Czolsonn/Oscyloskop/README.md

# Oscyloskop
Projekt amatorskiego oscyloskopu z wyświetlaczem LCD
