Czolsonn/Oscyloskop/Symulacje/_archiwum_stary_uklad/plot's/ADC_Input/ADC_Input_100_47.png

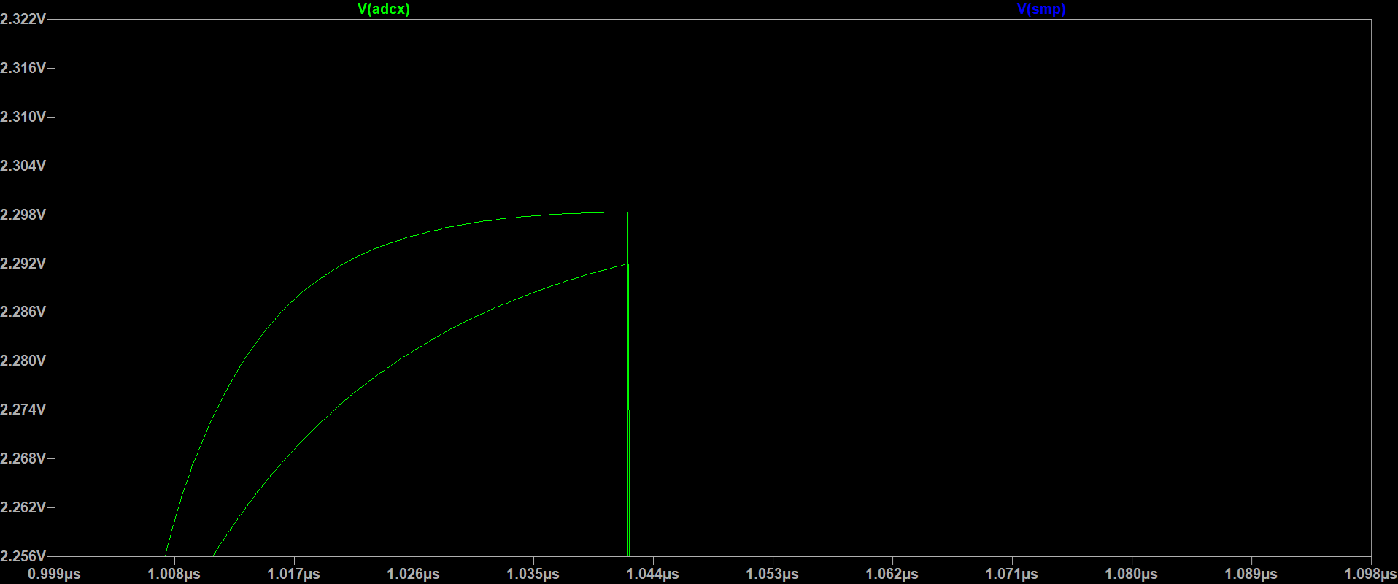
Symulacje/_archiwum_stary_uklad/plot's/ADC_Input/ADC_Input_100_47.png
