Czolsonn/Oscyloskop/Symulacje/_archiwum_stary_uklad/plot's/Bandwidth/Bandwidth.png

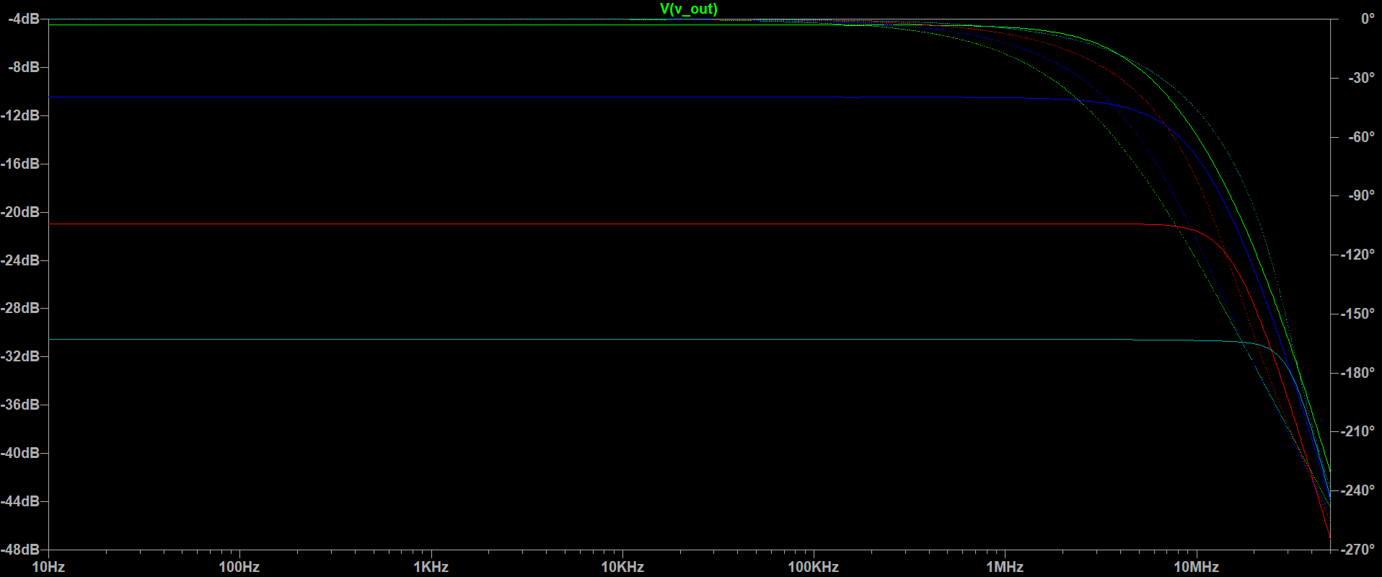
Symulacje/_archiwum_stary_uklad/plot's/Bandwidth/Bandwidth.png
