Czolsonn/Oscyloskop/Symulacje/_archiwum_stary_uklad/plot's/Bandwidth_AC/AC_bandwidth_all_G.png

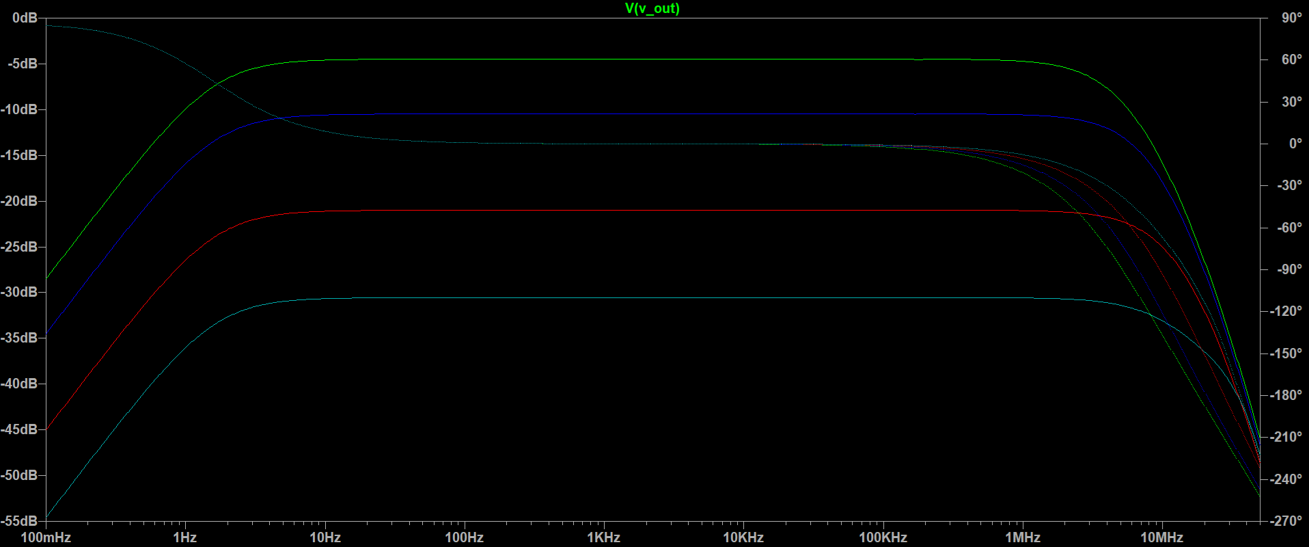
Symulacje/_archiwum_stary_uklad/plot's/Bandwidth_AC/AC_bandwidth_all_G.png
