Czolsonn/Oscyloskop/Symulacje/_archiwum_stary_uklad/plot's/Compensation_C_trim/Compensation_C_trim_closer.png

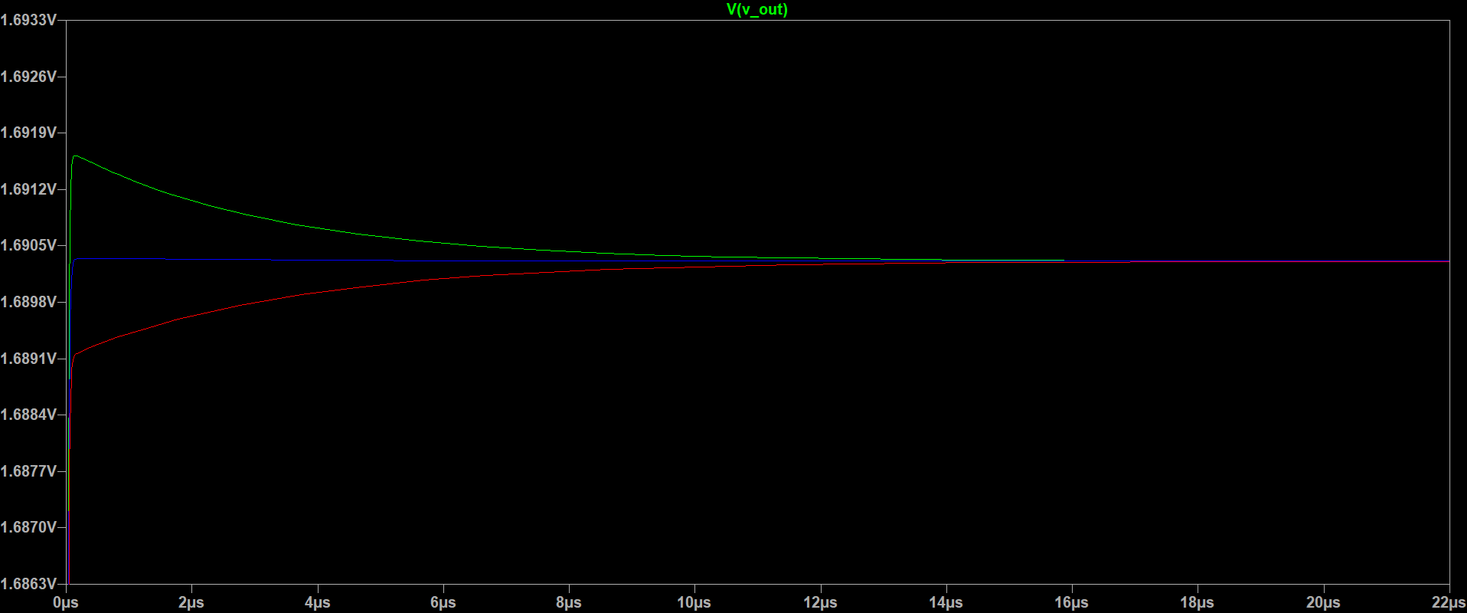
Symulacje/_archiwum_stary_uklad/plot's/Compensation_C_trim/Compensation_C_trim_closer.png
