Czolsonn/Oscyloskop/Symulacje/_archiwum_stary_uklad/plot's/Final/Final_1_signals.png

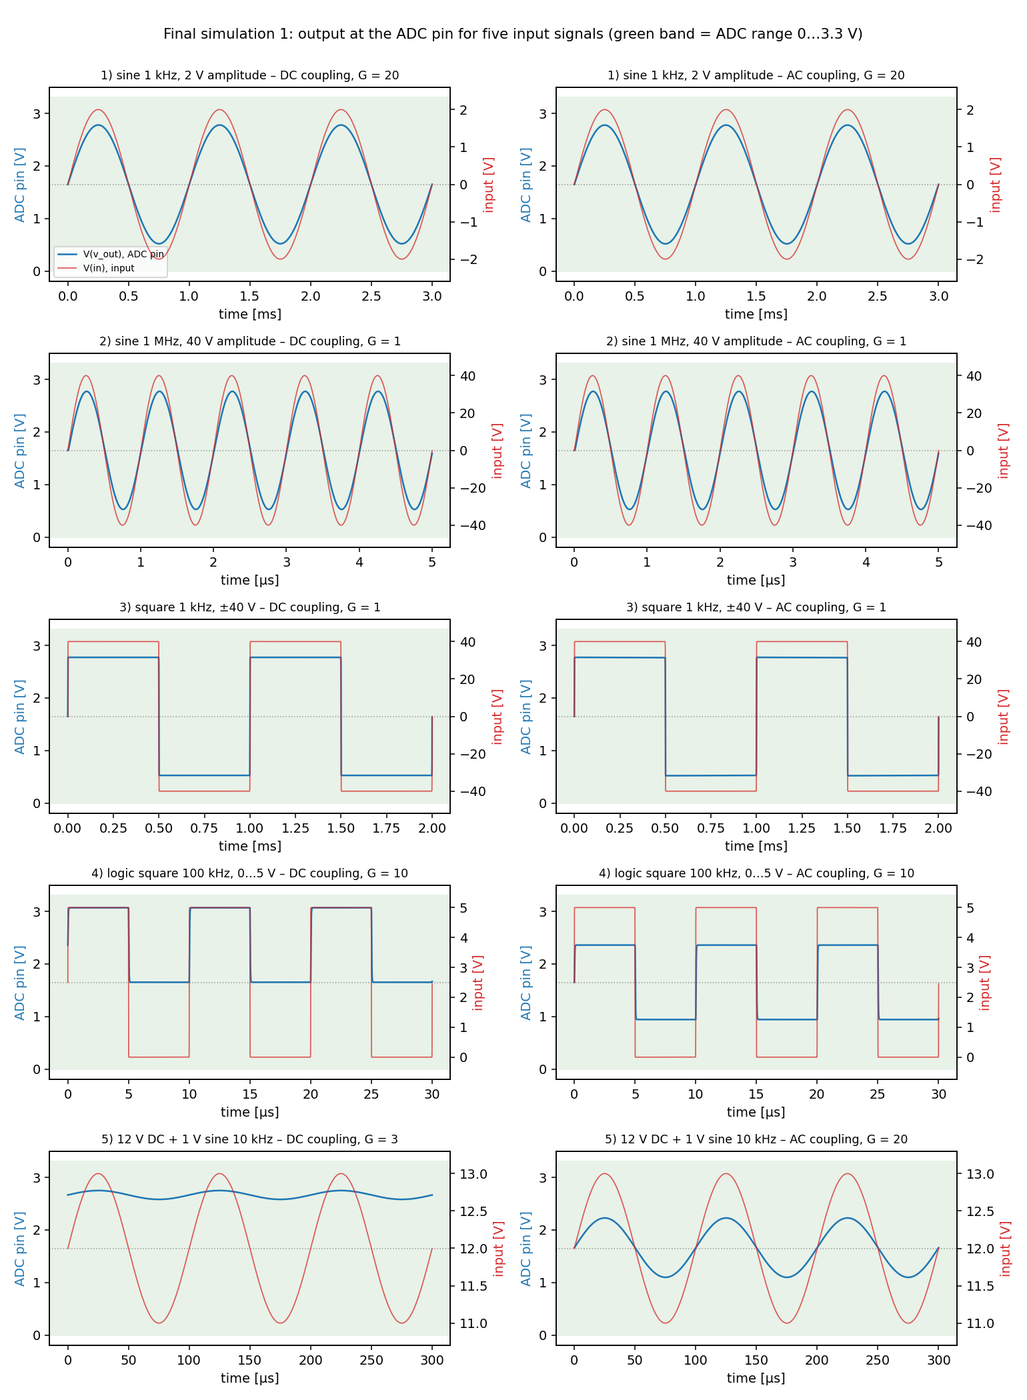
Symulacje/_archiwum_stary_uklad/plot's/Final/Final_1_signals.png
