Czolsonn/Oscyloskop/Symulacje/_archiwum_stary_uklad/plot's/Final/Final_1_square_edge.png

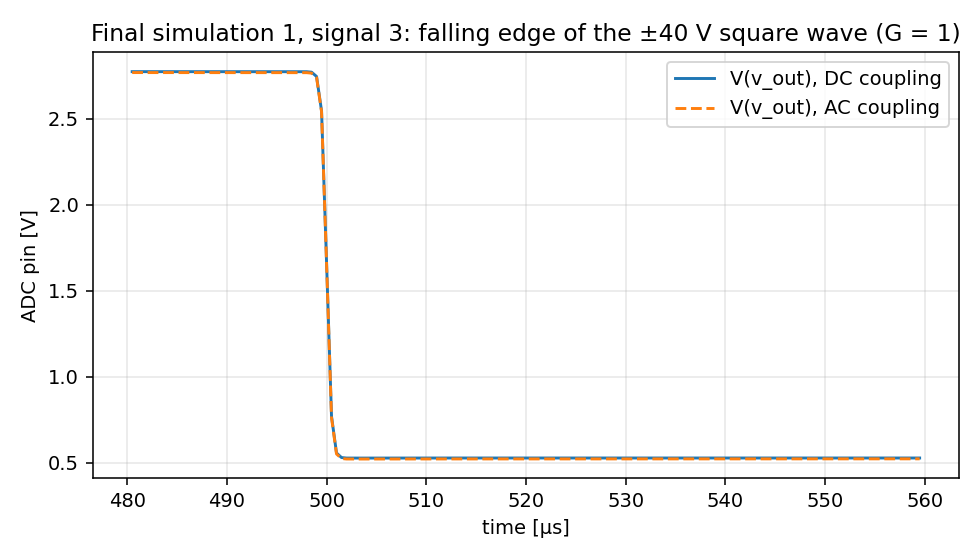
Symulacje/_archiwum_stary_uklad/plot's/Final/Final_1_square_edge.png
