Czolsonn/Oscyloskop/Symulacje/_archiwum_stary_uklad/plot's/Final/Final_2_AC_response.png

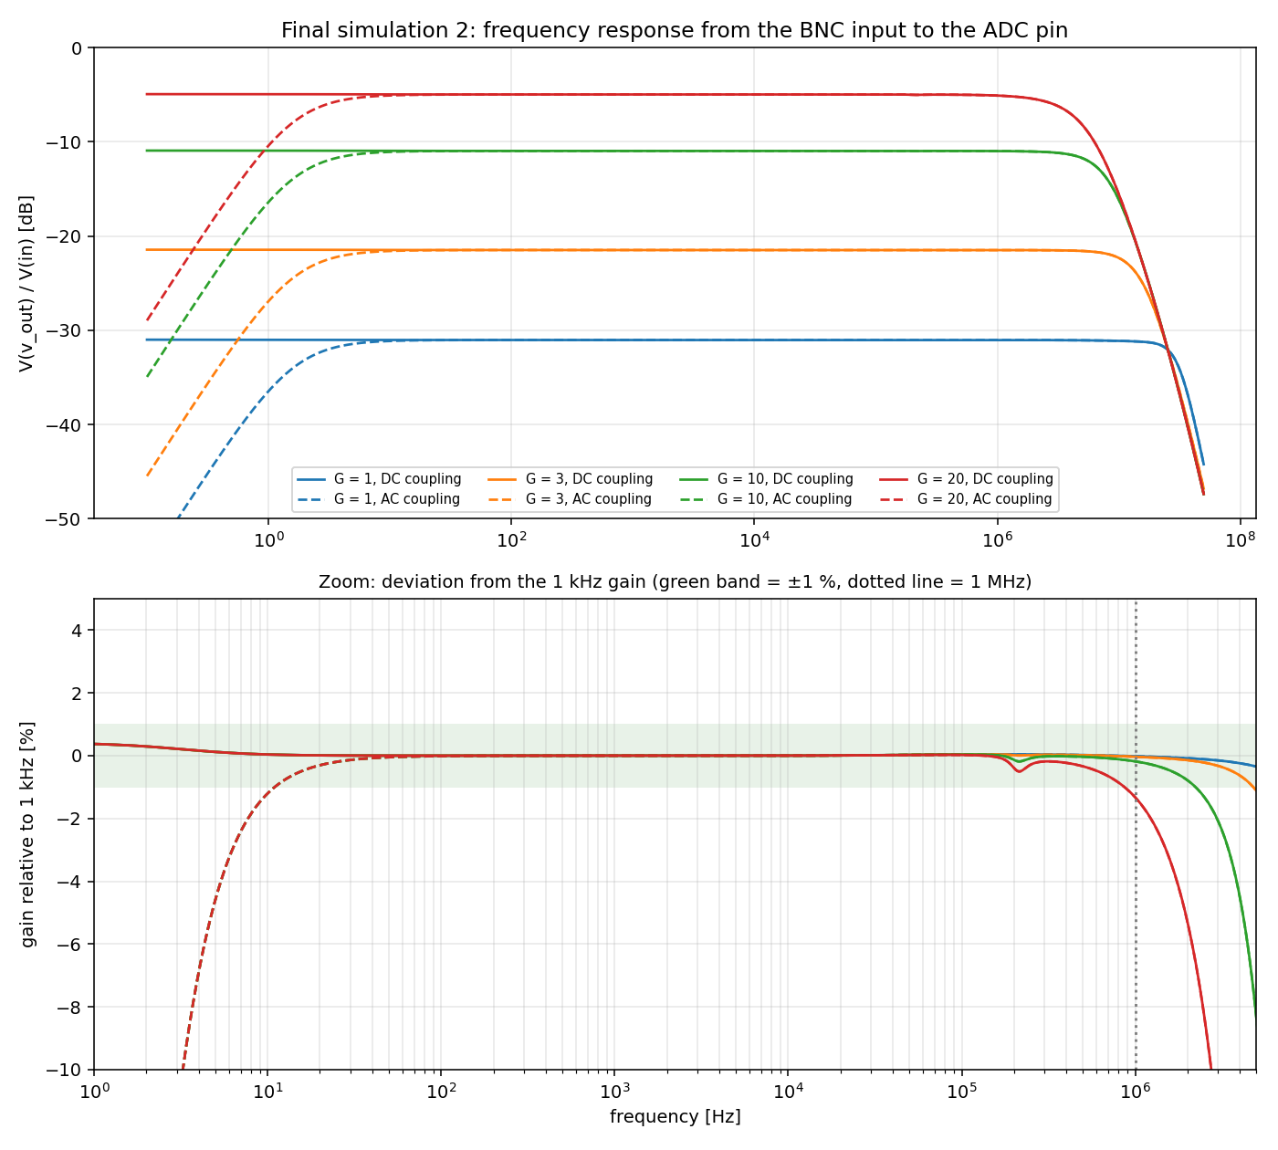
Symulacje/_archiwum_stary_uklad/plot's/Final/Final_2_AC_response.png
