Czolsonn/Oscyloskop/Symulacje/_archiwum_stary_uklad/plot's/Final/Final_3_offset_trim.png

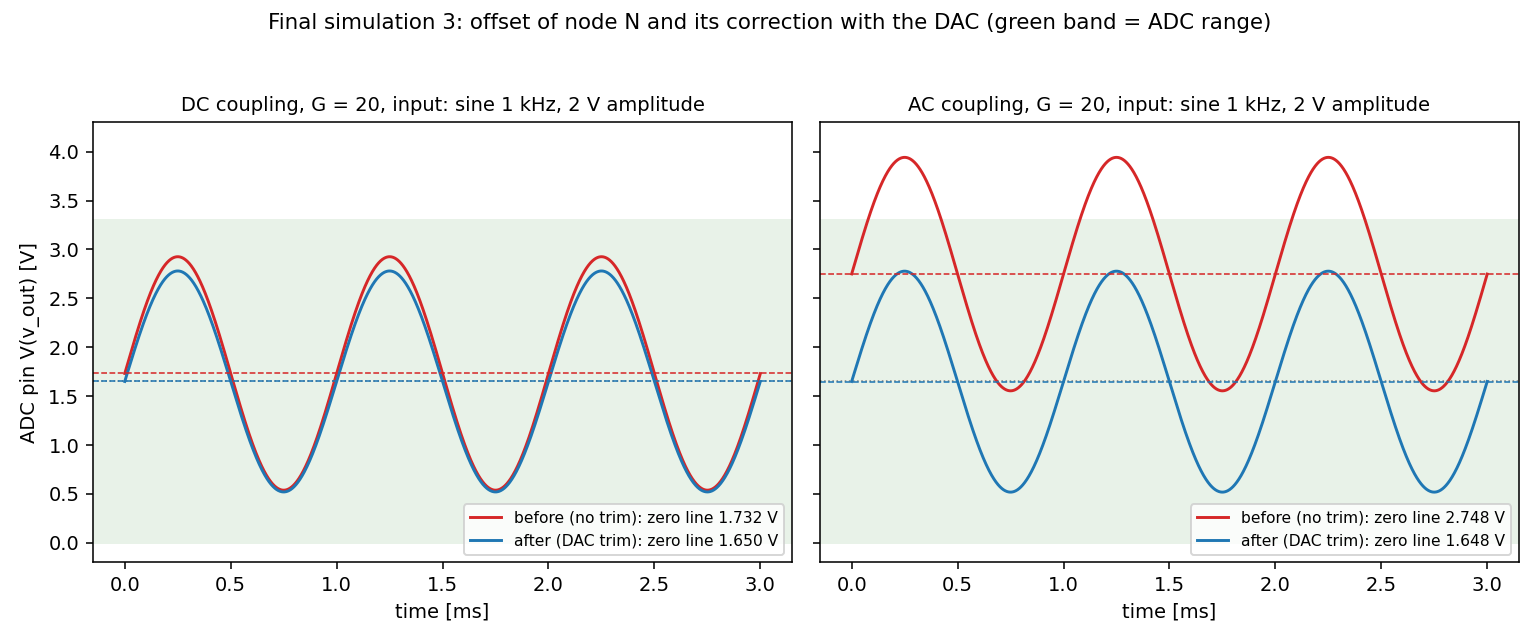
Symulacje/_archiwum_stary_uklad/plot's/Final/Final_3_offset_trim.png
