Czolsonn/Oscyloskop/Symulacje/_archiwum_stary_uklad/plot's/Monte_Carlo/MC_dc_bias.png

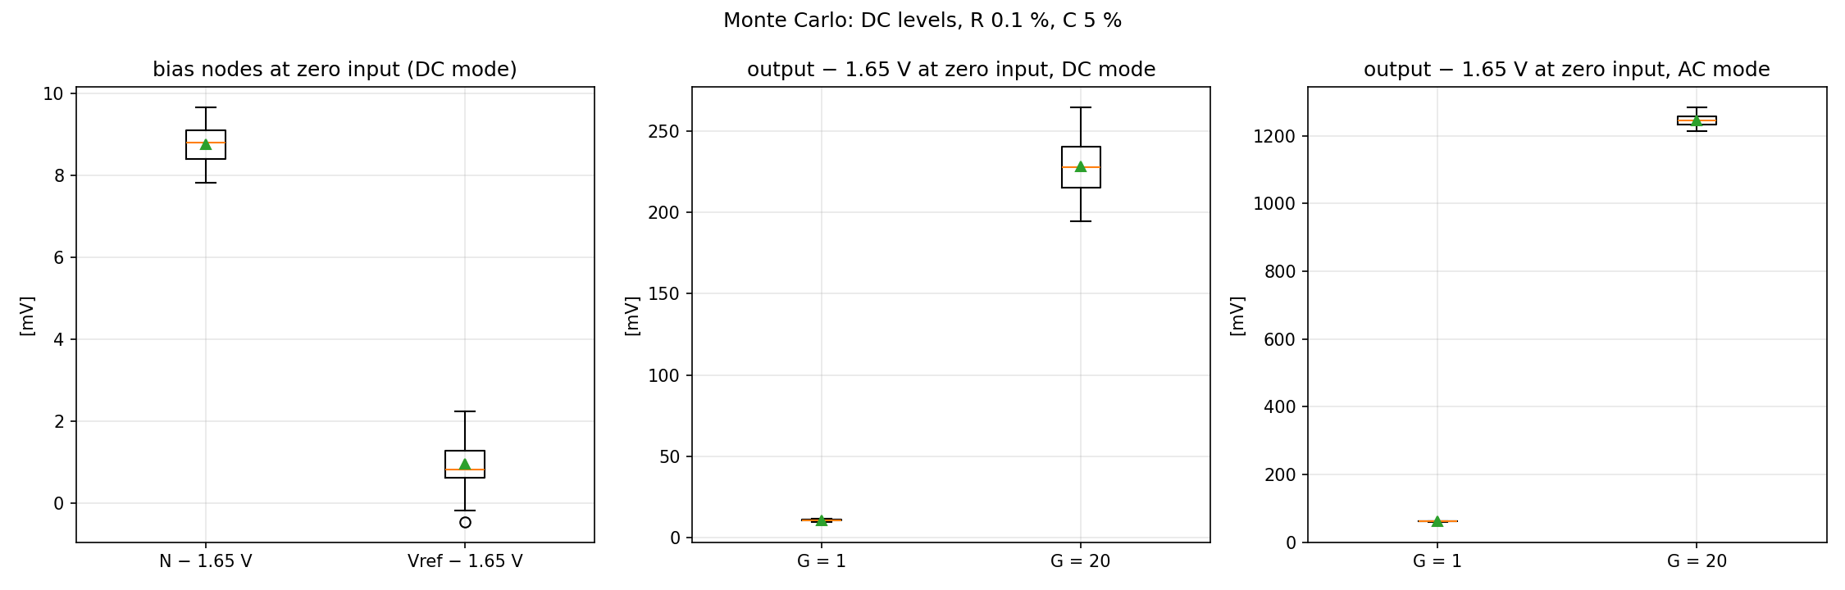
Symulacje/_archiwum_stary_uklad/plot's/Monte_Carlo/MC_dc_bias.png
