Czolsonn/Oscyloskop/Symulacje/_archiwum_stary_uklad/plot's/Power_filtration_LSB_effect/LSB_R_dump_C_bias.png

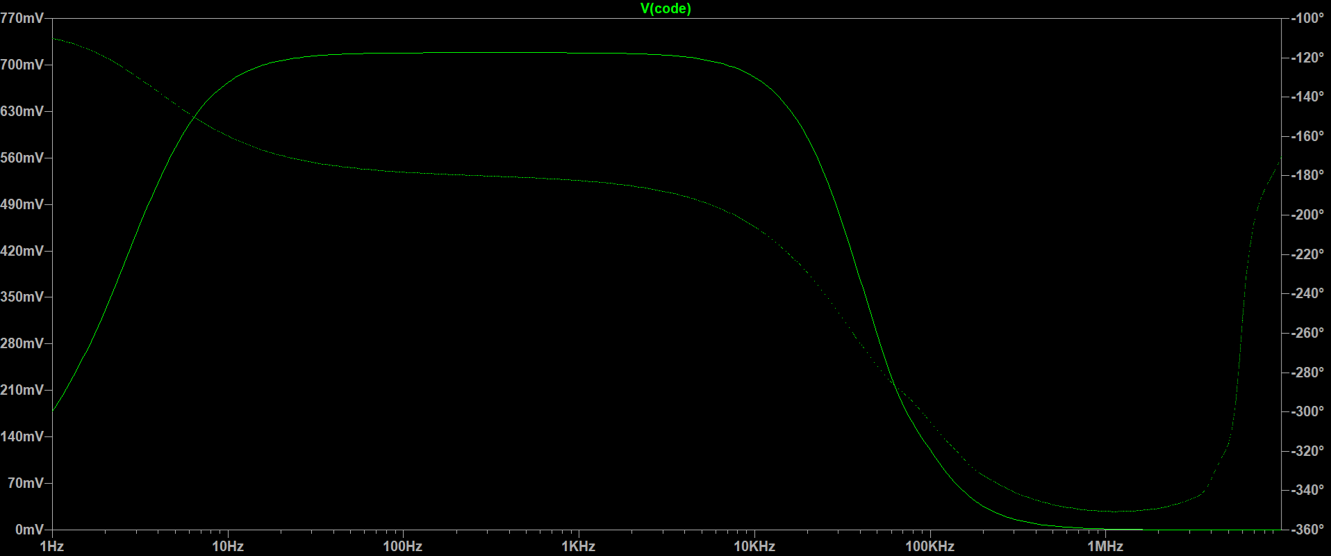
Symulacje/_archiwum_stary_uklad/plot's/Power_filtration_LSB_effect/LSB_R_dump_C_bias.png
