Czolsonn/Oscyloskop/Symulacje/plot's/AFE_v2/LTspice_figures/Fig01_AC_response.png

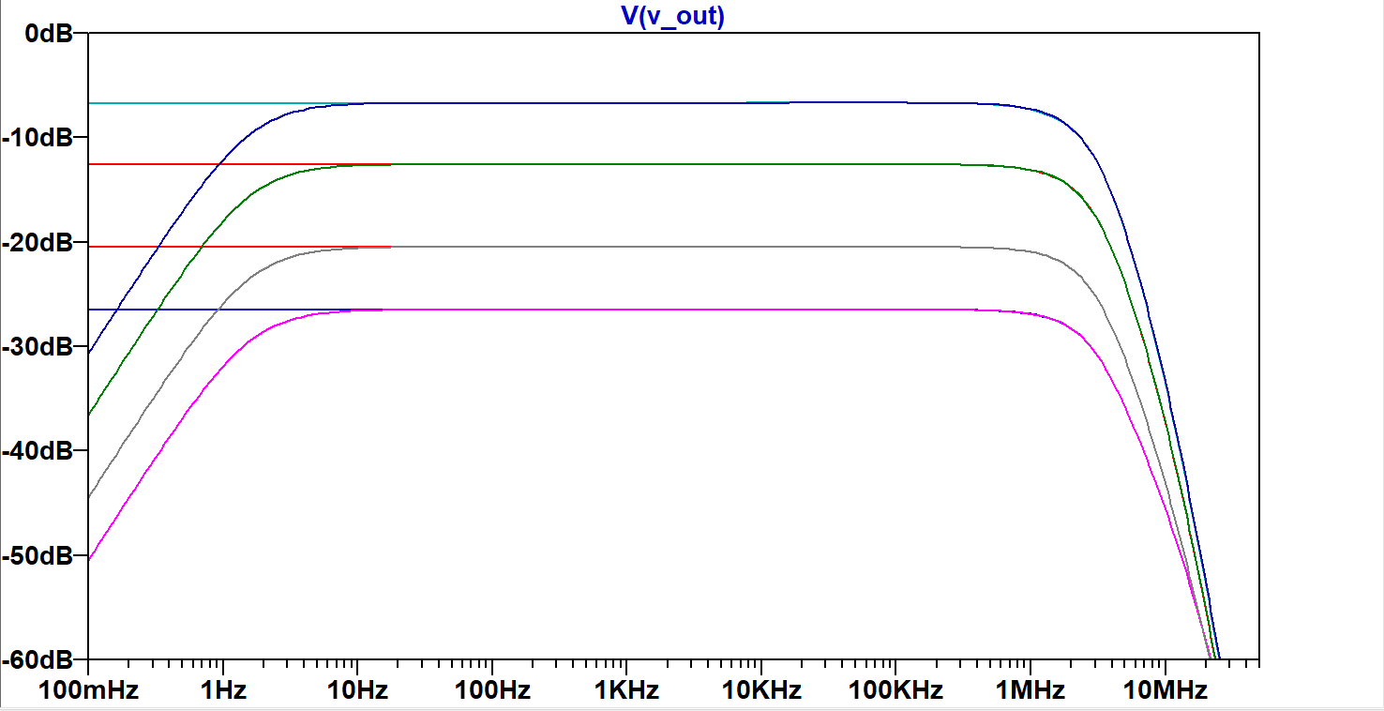
Symulacje/plot's/AFE_v2/LTspice_figures/Fig01_AC_response.png
