Czolsonn/Oscyloskop/Symulacje/plot's/AFE_v2/LTspice_figures/Fig02_sine_24V_G1.png

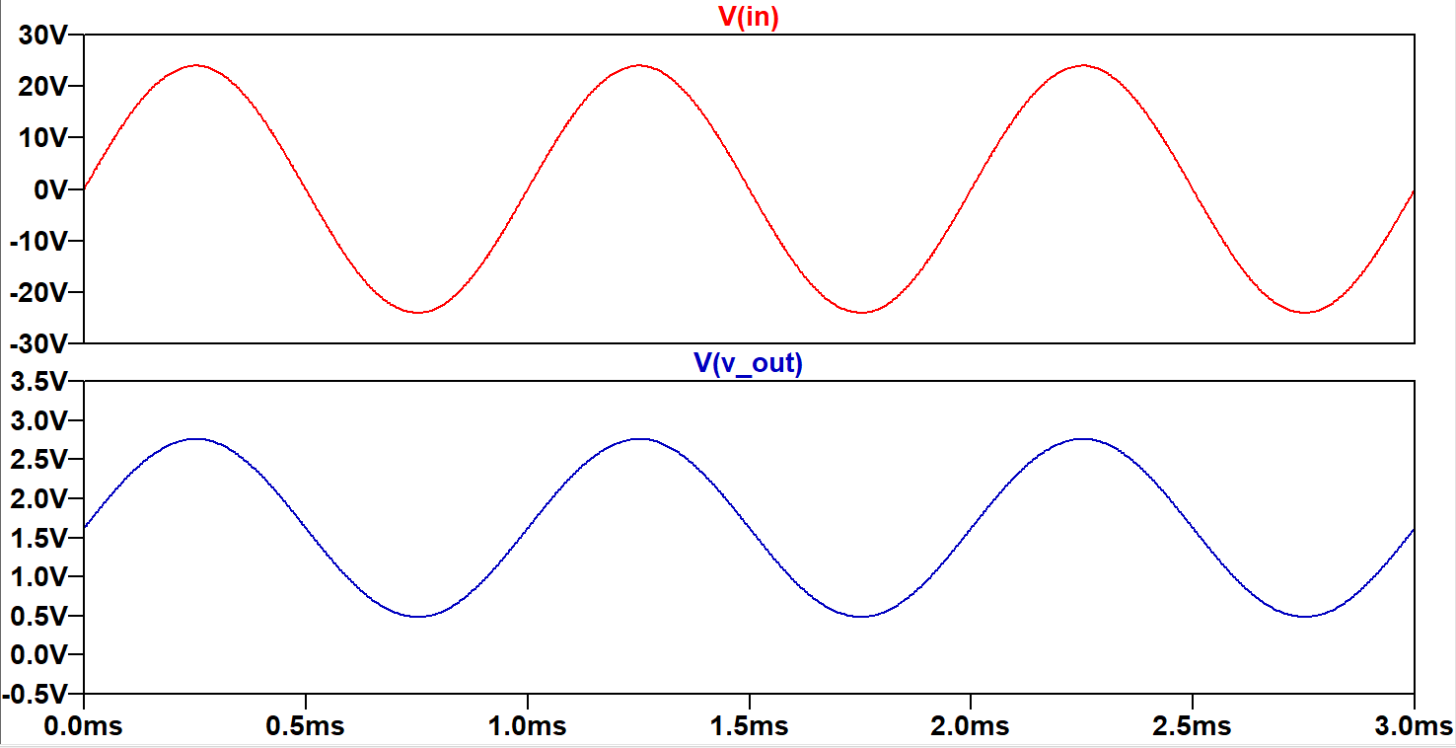
Symulacje/plot's/AFE_v2/LTspice_figures/Fig02_sine_24V_G1.png
