Czolsonn/Oscyloskop/Symulacje/plot's/AFE_v2/LTspice_figures/Fig03_square_24V_G1.png

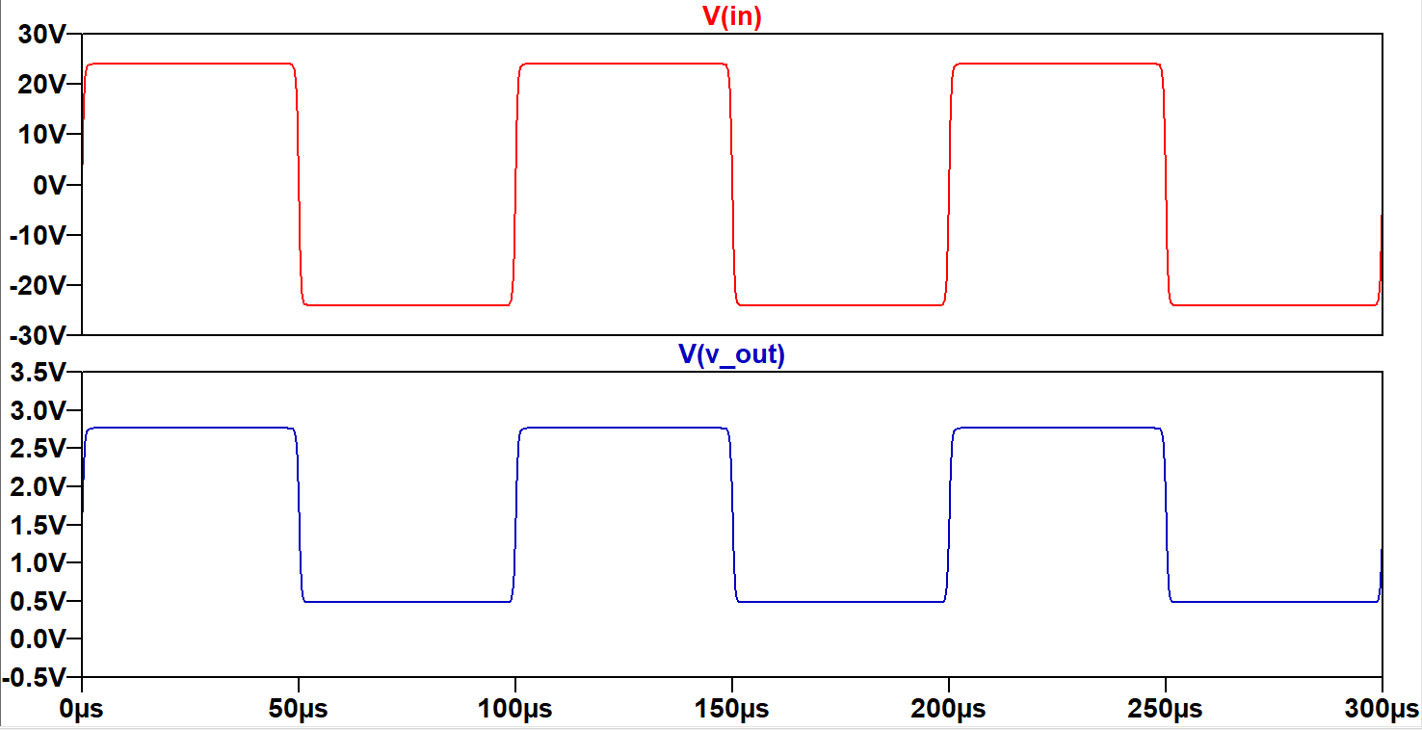
Symulacje/plot's/AFE_v2/LTspice_figures/Fig03_square_24V_G1.png
