Czolsonn/Oscyloskop/Symulacje/plot's/AFE_v2/LTspice_figures/Fig05_ripple_DC_G1_vs_AC_G10.png

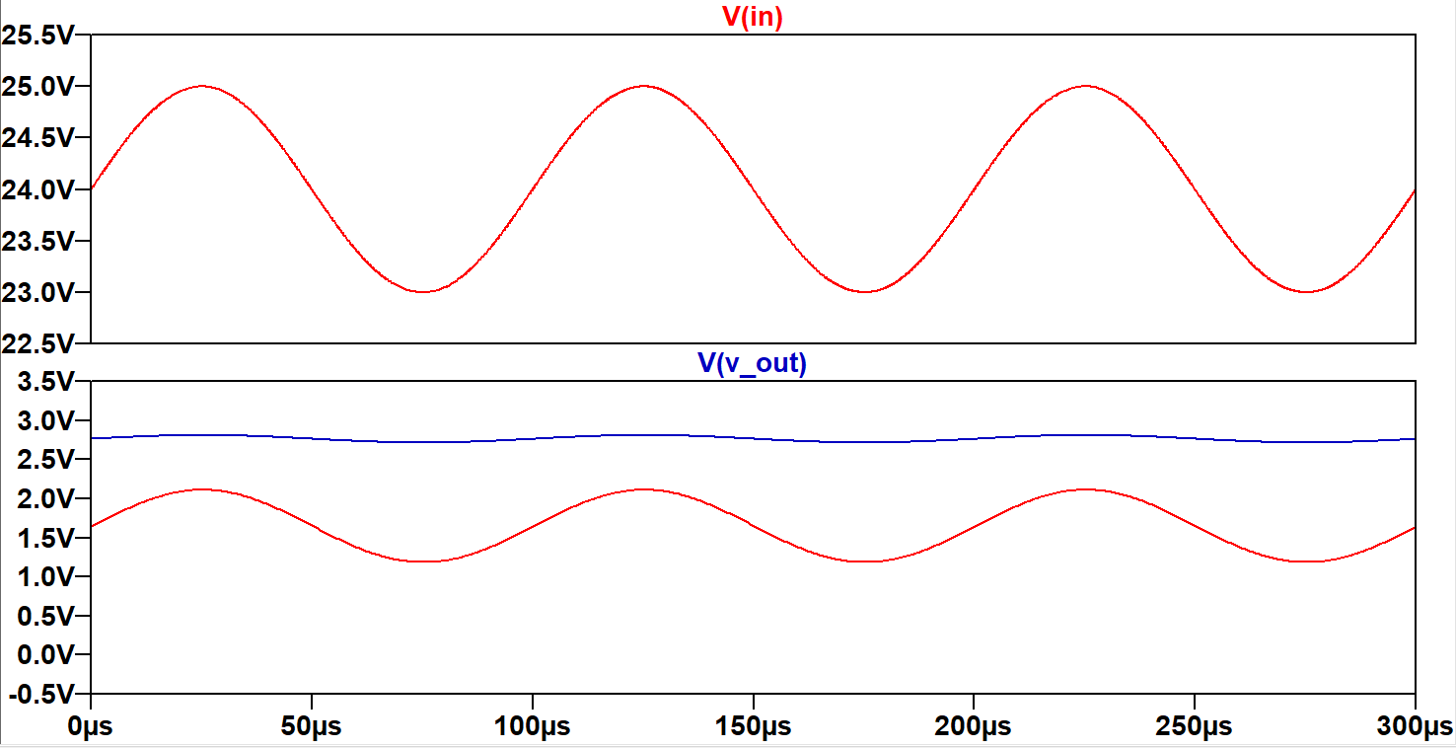
Symulacje/plot's/AFE_v2/LTspice_figures/Fig05_ripple_DC_G1_vs_AC_G10.png
