Czolsonn/Oscyloskop/Symulacje/plot's/AFE_v2/LTspice_figures/Fig08_square_1MHz_32V_G1.png

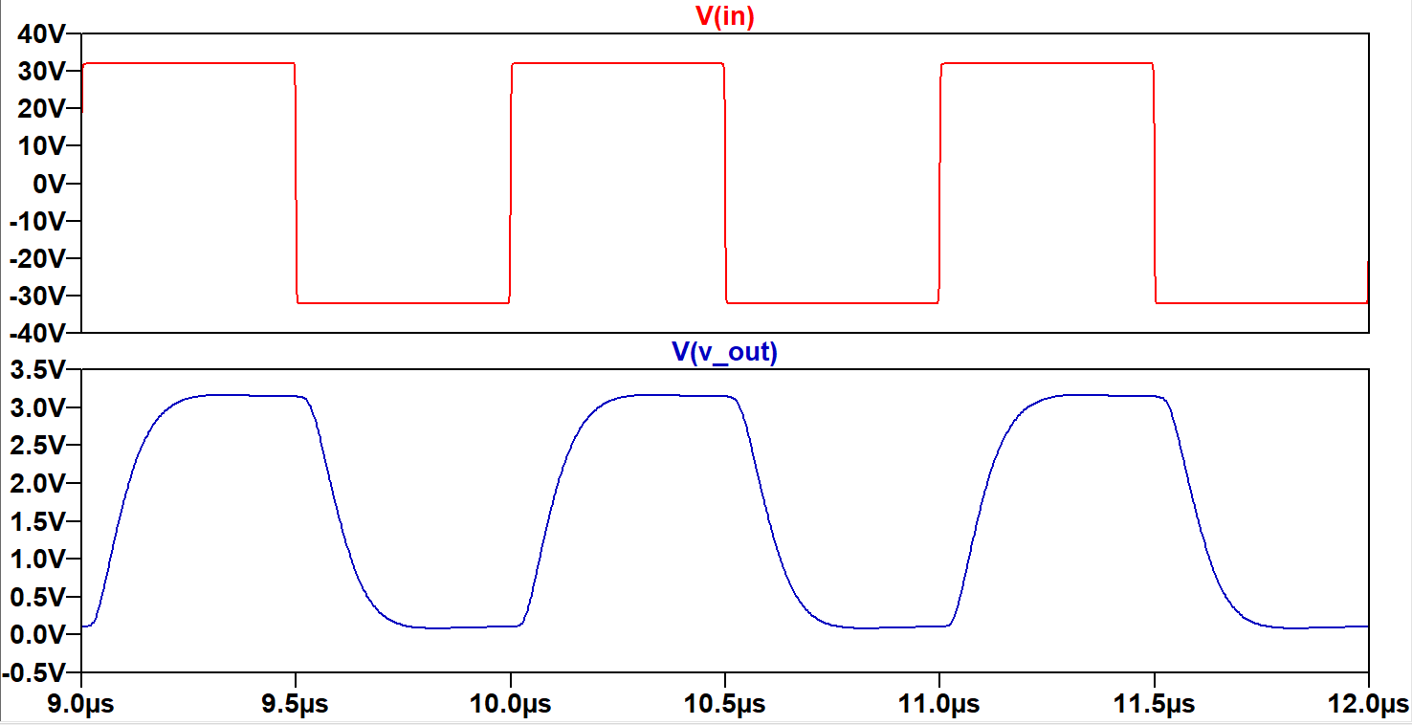
Symulacje/plot's/AFE_v2/LTspice_figures/Fig08_square_1MHz_32V_G1.png
