Czolsonn/Oscyloskop/Symulacje/plot's/AFE_v2/LTspice_figures/Fig09_edge_100kHz_32V_G1.png

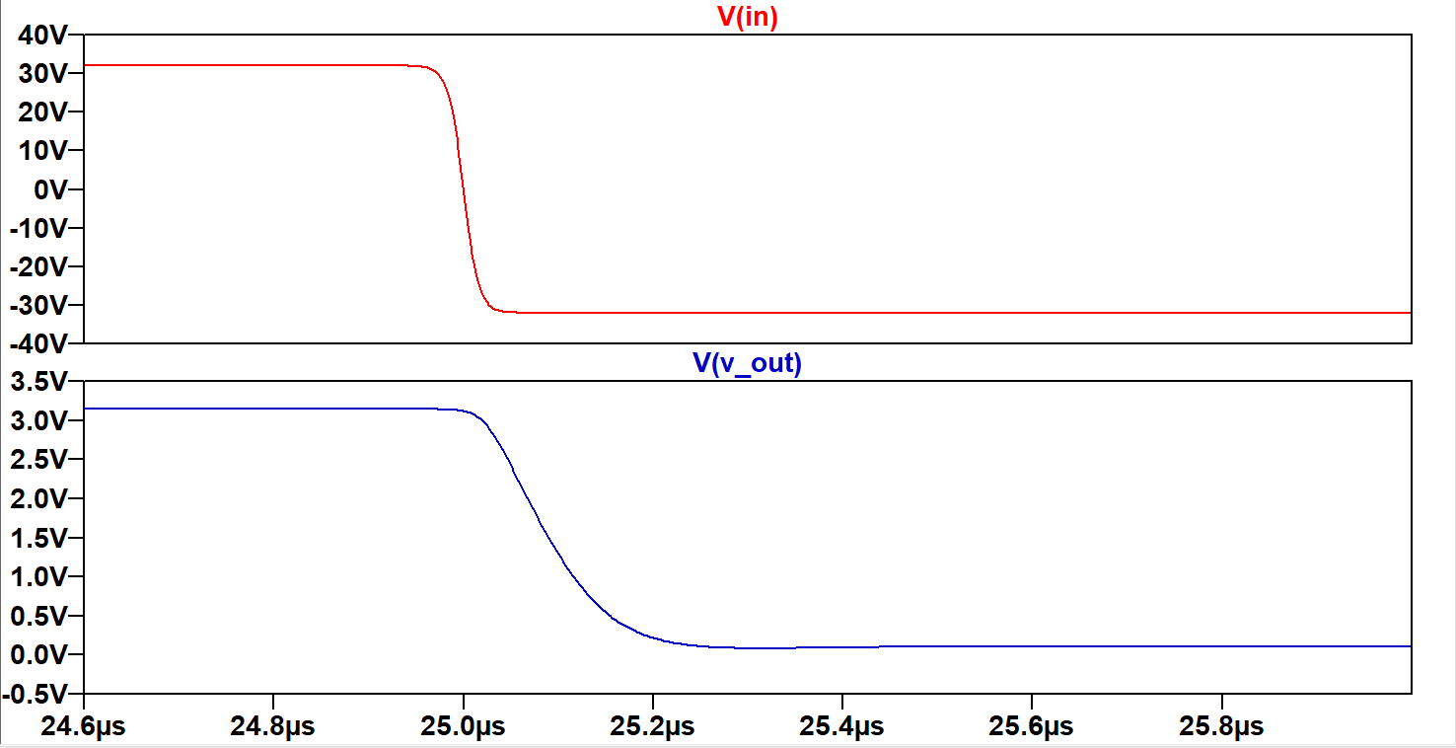
Symulacje/plot's/AFE_v2/LTspice_figures/Fig09_edge_100kHz_32V_G1.png
