Czolsonn/Oscyloskop/Symulacje/plot's/Bandwidth_AC/AC_mode_bandwidth_1G.png

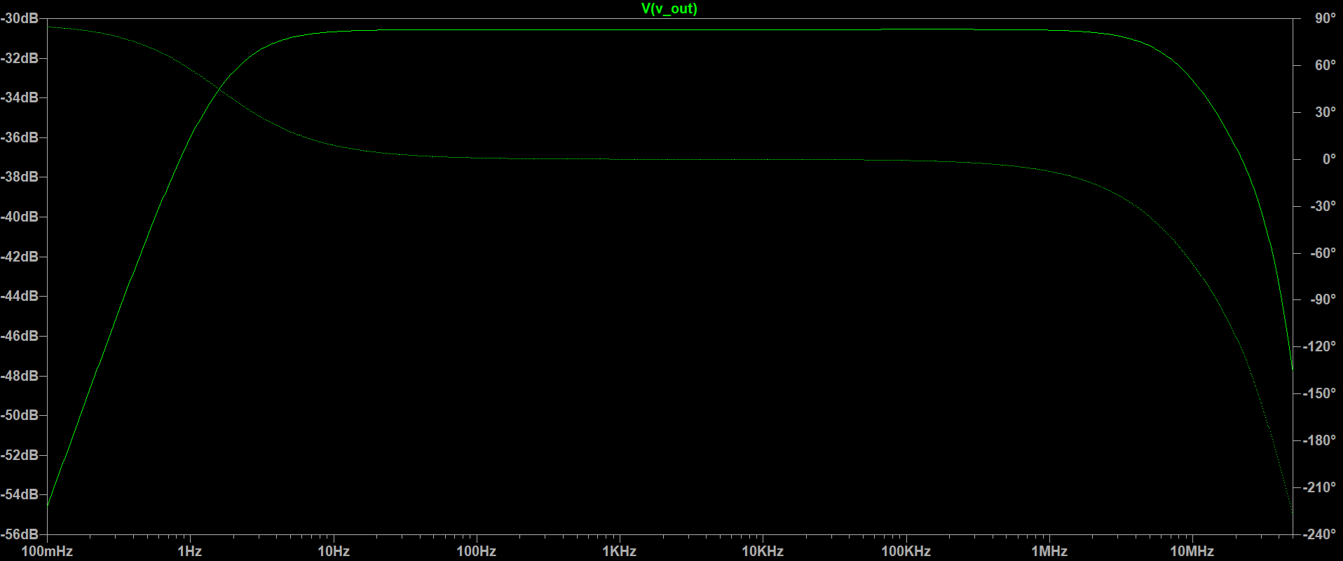
Symulacje/plot's/Bandwidth_AC/AC_mode_bandwidth_1G.png
