Czolsonn/Oscyloskop/Symulacje/plot's/Monte_Carlo/MC_compare_tolerances_G1.png

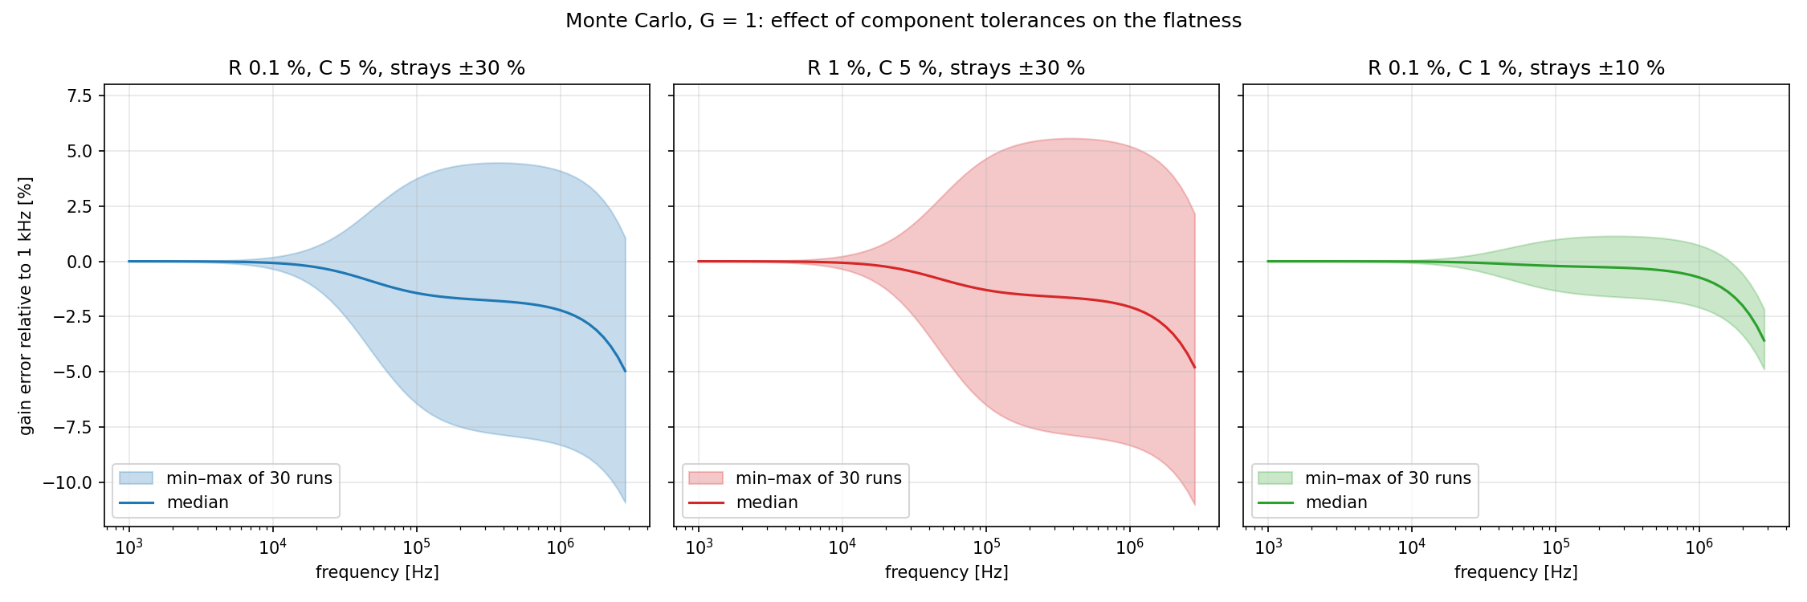
Symulacje/plot's/Monte_Carlo/MC_compare_tolerances_G1.png
