Czolsonn/Oscyloskop/Symulacje/plot's/Monte_Carlo/MC_histograms_G1.png

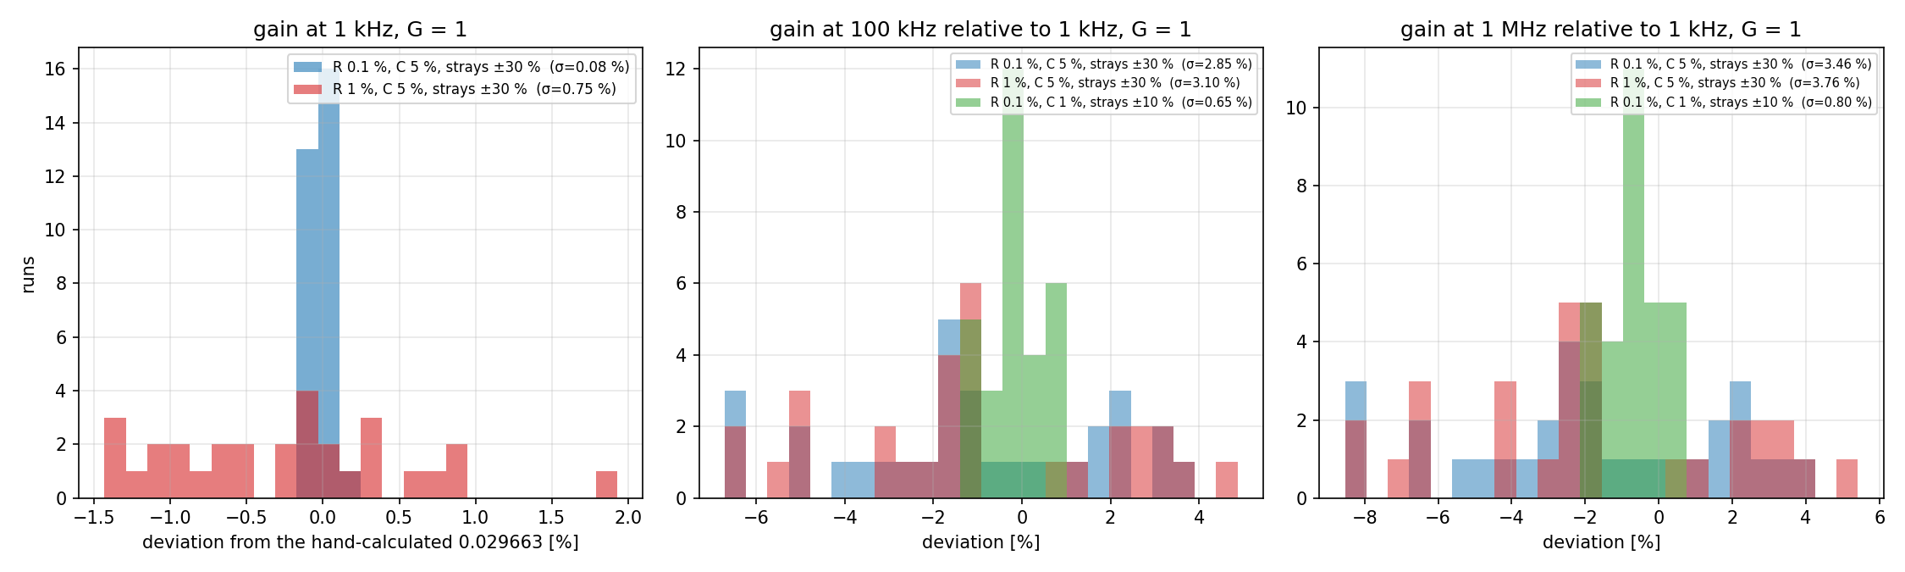
Symulacje/plot's/Monte_Carlo/MC_histograms_G1.png
