Czolsonn/Oscyloskop/Symulacje/plot's/Monte_Carlo/MC_response_AC_A_G1.png

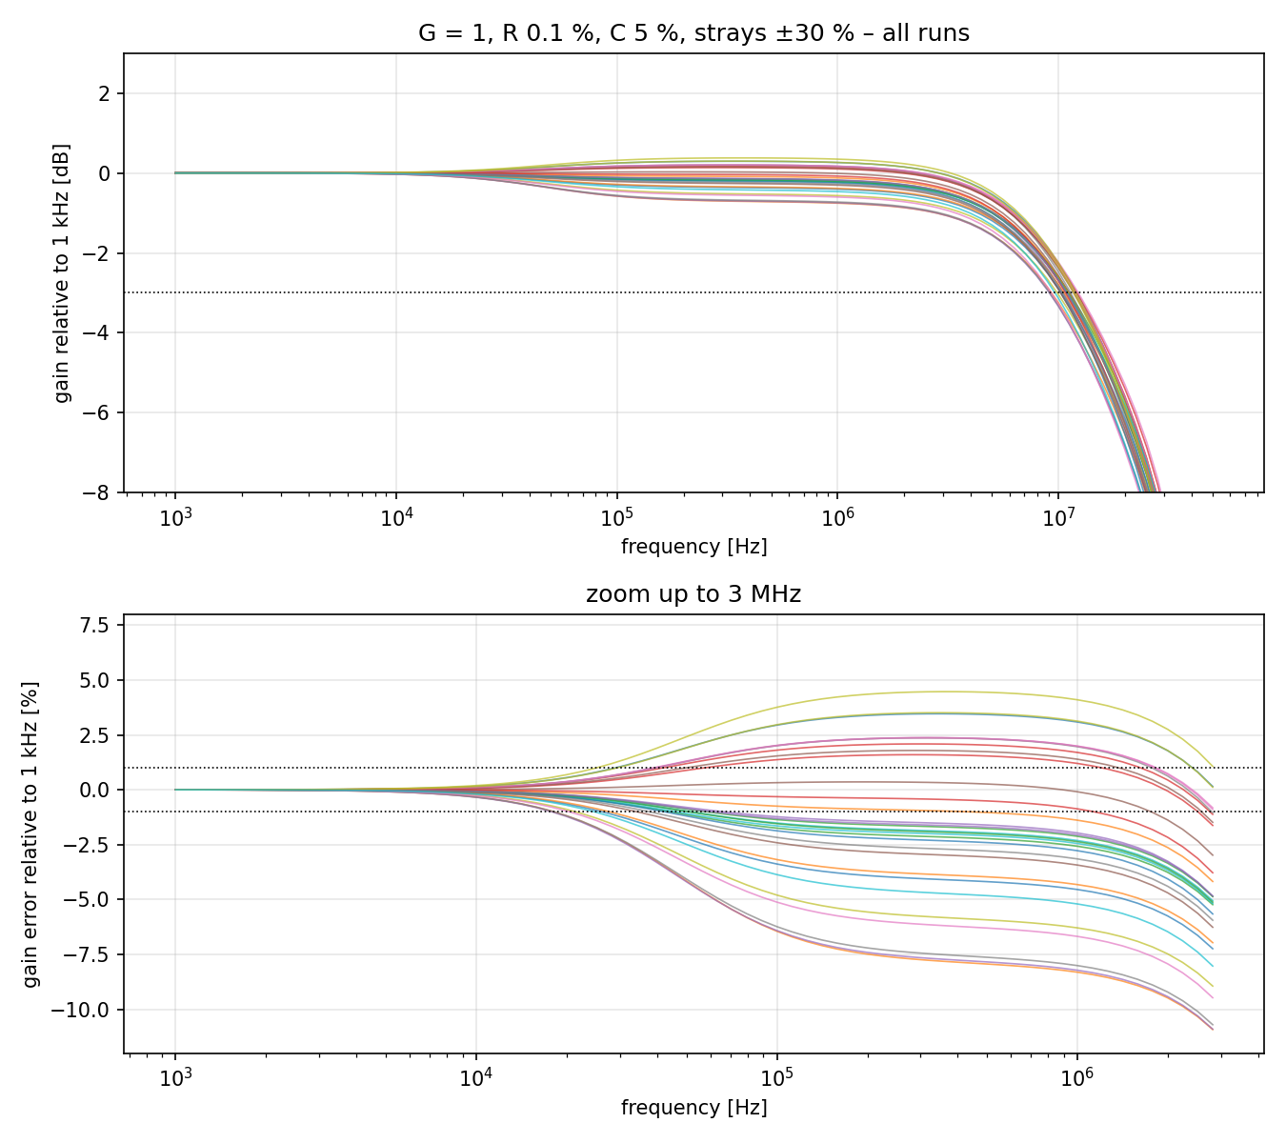
Symulacje/plot's/Monte_Carlo/MC_response_AC_A_G1.png
