Czolsonn/Oscyloskop/Symulacje/plot's/Monte_Carlo/MC_response_AC_A_G20.png

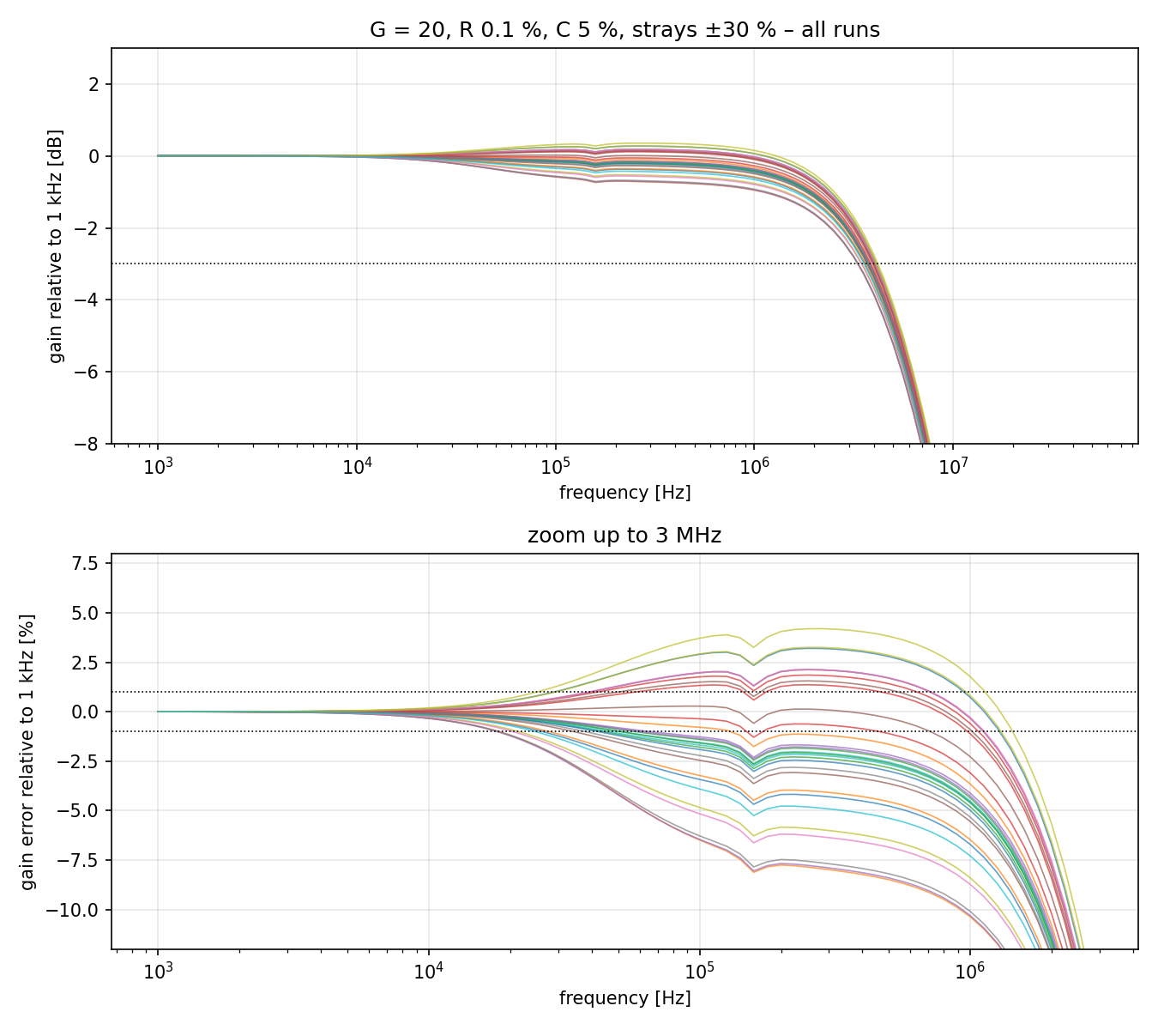
Symulacje/plot's/Monte_Carlo/MC_response_AC_A_G20.png
