Czolsonn/Oscyloskop/Symulacje/_archiwum_stary_uklad/plot's/Operating_Point_0V/Operating_point_0V.txt

time	V(v_out)
Step Information: Rg=52.3  (Step: 1/4)
0.000000000000000e+00	1.875070209569749e+00
9.765624940649698e-12	1.875070206954911e+00
1.259016433256794e-11	1.875070206196468e+00
1.823924311640442e-11	1.875070204681620e+00
2.953740068407738e-11	1.875070201705308e+00
5.213371581942330e-11	1.875070196122633e+00
9.732634609011514e-11	1.875070187852409e+00
1.877116066314988e-10	1.875070184924324e+00
3.684821277142662e-10	1.875070198678723e+00
6.535767439694688e-10	1.875070202774376e+00
9.501445575072377e-10	1.875070185624671e+00
1.543280184582776e-09	1.875070154703906e+00
2.275543171710117e-09	1.875070099736303e+00
3.691016904612535e-09	1.875069922223863e+00
5.704941088486135e-09	1.875069543865554e+00
9.241044209896019e-09	1.875068550136026e+00
1.551960613258294e-08	1.875066128865340e+00
2.635000272533695e-08	1.875061070339453e+00
4.694163051753055e-08	1.875051511332151e+00
8.376631552616635e-08	1.875038564303348e+00
1.509024129053474e-07	1.875025306869727e+00
2.485586629053474e-07	1.875016964762456e+00
3.462149129053474e-07	1.875014522518468e+00
4.438711629053474e-07	1.875015263657366e+00
5.415274129053473e-07	1.875017765763814e+00
6.391836629053473e-07	1.875021150422845e+00
7.368399129053474e-07	1.875024902249810e+00
8.344961629053474e-07	1.875028725795624e+00
9.321524129053475e-07	1.875032453703701e+00
1.029808662905348e-06	1.875035998283217e+00
1.127464912905348e-06	1.875039316866762e+00
1.225121162905348e-06	1.875042394613579e+00
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
1.690499996379913e-06	1.660646782564652e+00
1.788156246379913e-06	1.660646782564650e+00
1.885812496379913e-06	1.660646782564653e+00
1.983468746379913e-06	1.660646782564652e+00
2.081124996379913e-06	1.660646782564652e+00
2.178781246379913e-06	1.660646782564655e+00
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
