Czolsonn/Oscyloskop/Symulacje/plot's/Operating_Point_0V/Operating_point_0V.png

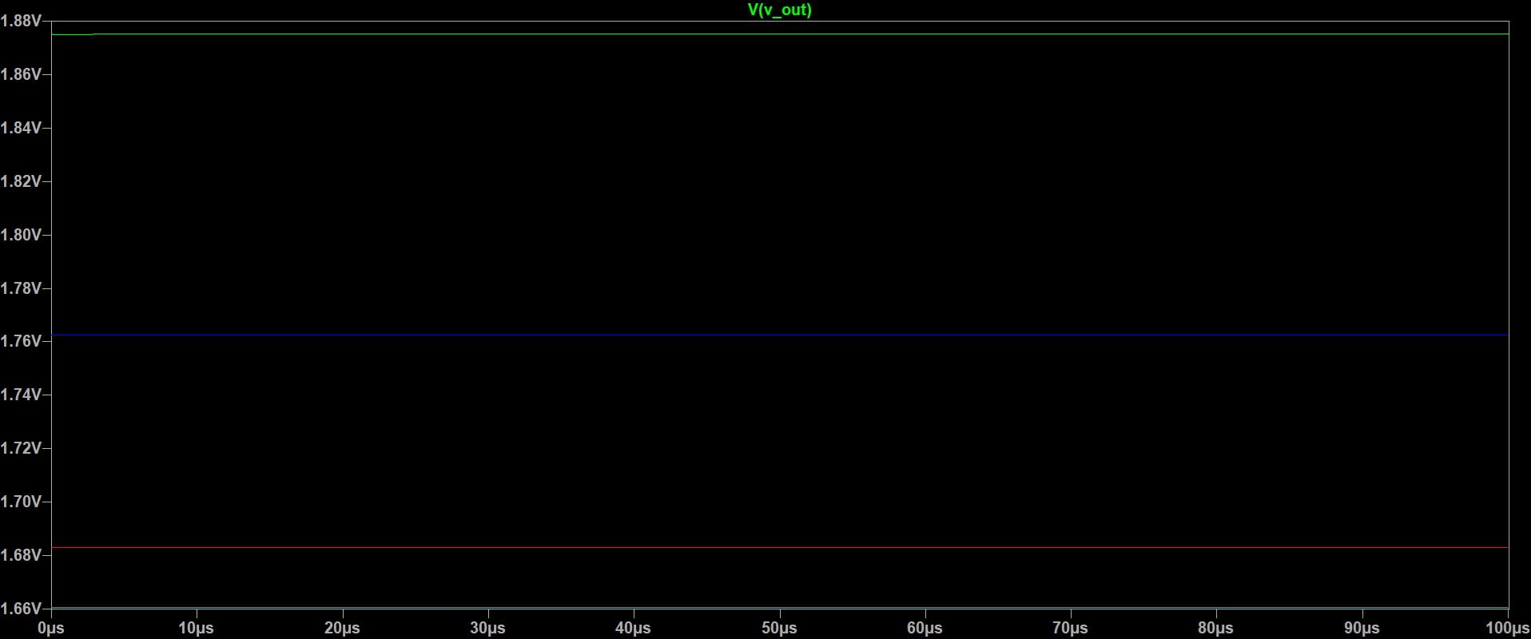
Symulacje/plot's/Operating_Point_0V/Operating_point_0V.png
