Czolsonn/Oscyloskop/Symulacje/Model_test_AQY212S.asc

K1: AQY212S
R1: res; 390
RL: res; 100
VGPIO: voltage; PULSE(0 3.3 1m 1u 1u 3m 10m)
VT: voltage; 1
Named nets: led, 0, o1, gpio, vt
.tran 0 6m 0 1u
.meas TRAN i_led FIND I(R1) AT 3m
.meas TRAN v_led FIND V(led) AT 3m
.meas TRAN ron FIND V(o1)/I(RL) AT 3m
.meas TRAN roff FIND V(o1)/I(RL) AT 0.5m
.meas TRAN t_on WHEN V(o1)=0.5 FALL=1
.meas TRAN t_off WHEN V(o1)=0.5 RISE=1
.meas TRAN ton PARAM t_on-1m
.meas TRAN toff PARAM t_off-4m
