Czolsonn/Oscyloskop/Symulacje/Model_test_ESD2CAN36.asc

D1: ESD2CAN36-Q1
VIO: voltage; 0
Named nets: io1, 0
.dc VIO -45 45 0.01
.meas DC i_at_24V FIND -I(VIO) AT 24
.meas DC i_at_32V FIND -I(VIO) AT 32
.meas DC i_at_36V FIND -I(VIO) AT 36
.meas DC v_at_10mA WHEN -I(VIO)=10m
.meas DC v_at_m10mA WHEN -I(VIO)=-10m
