Czolsonn/Oscyloskop/Symulacje/Model_test_ESD2CAN36_C0.asc

D1: ESD2CAN36-Q1
VIO: voltage; DC {vb} AC 1
Named nets: io1, 0
.ac list 1e6
.param vb=0
.meas AC c_pF_at_0V FIND Im(I(VIO))/(2*pi*1e6)*1e12 AT 1e6
