Czolsonn/Oscyloskop/Symulacje/Model_test_TMUX1104.asc

R1: res; 1k
R2: res; 1k
R3: res; 1k
R4: res; 1k
U1: TMUX1104
VA0: voltage; PULSE(0 3.3 1u 2n 2n 1u 2u)
VA1: voltage; PULSE(0 3.3 2u 2n 2n 2u 4u)
VD: voltage; 1.625
VDD: voltage; 5
VEN: voltage; PULSE(3.3 0 4.5u 2n 2n 1u 10u)
VS: voltage; 2.625
Named nets: a0, s1, 0, s3, en, vdd, s4, d, s2, a1, vs
.tran 0 5u 0 1n
.meas TRAN ron1 FIND (V(s1)-V(d))/I(R1) AT 0.8u
.meas TRAN ron2 FIND (V(s2)-V(d))/I(R2) AT 1.8u
.meas TRAN ron3 FIND (V(s3)-V(d))/I(R3) AT 2.8u
.meas TRAN ron4 FIND (V(s4)-V(d))/I(R4) AT 3.8u
.meas TRAN ioff_s1_at2u FIND I(R1) AT 1.8u
.meas TRAN ioff_all_en0 FIND I(R1)+I(R2)+I(R3)+I(R4) AT 5u
.meas TRAN t_s1_off WHEN I(R1)=0.5m FALL=1
.meas TRAN t_s2_on WHEN I(R2)=0.5m RISE=1
.meas TRAN bbm PARAM (t_s2_on-t_s1_off)
