Czolsonn/Oscyloskop/Symulacje/plot's/Operating_Point_0V/Analog Front End_operating_point_0V.asc

C2: cap; 3.3p; Rser=1 Lser=0.5n
C3: cap; 82p; Rser=0.3 Lser=0.7n
C4: cap; 0.1µ; V=100 Irms=0 Rser=0.03 Lser=0.8n Rpar=1G
C5: cap; 27p; Rser=1 Lser=1n
C6: cap; 3p
C7: cap; 0.15p
C8: cap; 3.7p; Rser=0.2 Lser=0.5n
C9: cap; 2p
C10: cap; 0.1p
C11: cap; 150p; Rser=0.2 Lser=0.7n
C12: cap; 15p
C13: cap; 10µ; Rser=0.02 Lser=1.5n
C14: cap; 100n; Rser=0.05 Lser=0.7n
C15: cap; 10µ; Rser=0.02 Lser=1.5n
C16: cap; 100n; Rser=0.05 Lser=0.7n
R1: res; 57.6k
R2: res; 10k
R3: res; 10k
R4: res; 976k
R5: res; 61.9k
R6: res; 1k
R9: res; {Rg}
R10: res; 100
U1: G6K_SPDT
U2: LMH6642
U3: OPA354
U4: OPA354
V1: voltage; 0; Rser=50 Cpar=100p
V2: voltage; 3.3
V7: voltage; PULSE(0 5 0.5m 1u 1u 0.4m 1m 100)
V8: voltage; 5; Rser=0.1
Named nets: 0, V_out, PULSE, 5+, Vref, N, bufo, inm, out5, mid, v33
.param Rg=1G
.options plotwinsize=0 numdgt=15 noopiter gminsteps=0
.nodeset V(5+)=5 V(v33)=3.3 V(n)=1.65 V(bufo)=1.65 V(vref)=1.65 V(mid)=1.65 V(inm)=1.65 V(out5)=1.65 V(v_out)=1.65
.meas AC gmid FIND mag(V(v_out)) AT 1k
.meas AC g100k FIND mag(V(v_out)) AT 100k
.meas AC g1M FIND mag(V(v_out)) AT 1Meg
.meas AC f3db WHEN mag(V(v_out))=gmid/sqrt(2) FALL=1
.step param Rg list 1G 499 110 52.3
.tran 100u
