Czolsonn/Oscyloskop/Symulacje/Analog Front End.asc

C1: cap; 3.3p; Rser=1 Lser=1n
C2: cap; 10n; Rser=1 Lser=1n
C3: cap; 47p; Rser=0.3 Lser=0.7n
C4: cap; 22p; Rser=0.3 Lser=0.7n
C5: cap; 15.6p; Rser=1 Lser=1n
C6: cap; 3p
C7: cap; 30p; Rser=0.3 Lser=0.7n
C8: cap; 22p; Rser=0.3 Lser=0.7n
C9: cap; 150p; Rser=0.2 Lser=0.7n
C10: cap; 15p
C13: cap; 10µ; Rser=1.02 Lser=1.5n
C14: cap; 100n; Rser=0.05 Lser=0.7n
C15: cap; 10µ; Rser=0.02 Lser=1.5n
C16: cap; 100n; Rser=0.05 Lser=0.7n
R1: res; 90.9k
R2: res; 100k
R3: res; 100k
R4: res; 953k
R5: res; 100k
R6: res; 499
R7: res; 390
R8: res; 54.9
R9: res; 124
R10: res; 10Meg
R11: res; 499
R12: res; 1.96k
R13: res; 1.96k
R14: res; 47
U1: AQY212S
U2: OPA354
U3: OPA354
U4: OPA354
U6: TMUX1104
U7: ESD2CAN36-Q1
V1: voltage; SINE(0 40 50k); AC 1; Rser=50 Cpar=100p
V2: voltage; 3.25
V4: voltage; 3.3
V7: voltage; {3.3*(1-kAC)}
V8: voltage; 5; Rser=0.1
VA0: voltage; {3.3*(gsel-2*floor(gsel/2))}
VA1: voltage; {3.3*floor(gsel/2)}
Named nets: 0, v33, PULSE, 5+, N, bufo, mid, vdda, Vref, V_out, out5, a0, a1, inp, in
.ac dec 100 10 50Meg
.param gsel=0 kAC=0
gsel = gain (TMUX1104 A1 A0 from the 74HC595):  0 = G1 (S1, open)   1 = G2 (S2, 499)   2 = G5 (S3, 124)   3 = G10 (S4, 54.9)
kAC = coupling:  0 = DC (PhotoMOS closed, GPIO high)   1 = AC (PhotoMOS open, 10 nF + 10 M to VMID)
vdda = VREF+ of the Nucleo (3.25 V) = ADC full scale;  v33 = 3V3 of the Nucleo (filter op-amp supply)
.options plotwinsize=0 numdgt=15 noopiter gminsteps=0 method=gear abstol=1e-10 reltol=0.003 vntol=1e-5
.nodeset V(5+)=5 V(v33)=3.3 V(vdda)=3.25 V(n)=1.625 V(inp)=1.625 V(bufo)=1.625 V(vref)=1.625 V(mid)=1.625 V(out5)=1.625 V(v_out)=1.625
.meas AC gmid FIND mag(V(v_out)) AT 1k
.meas AC g100k FIND mag(V(v_out)) AT 100k
.meas AC g1M FIND mag(V(v_out)) AT 1Meg
.meas AC f3db WHEN mag(V(v_out))=gmid/sqrt(2) FALL=1
