Czolsonn/Oscyloskop/Symulacje/_archiwum_stary_uklad/Analog Front End_ADC_settling.asc

C2: cap; 3.3p; Rser=1 Lser=0.5n
C3: cap; 82p; Rser=0.3 Lser=0.7n
C4: cap; 0.1µ; V=100 Irms=0 Rser=0.03 Lser=0.8n Rpar=1G
C5: cap; 27p; Rser=1 Lser=1n
C6: cap; 3p
C7: cap; 0.15p
C8: cap; 3.7p; Rser=0.2 Lser=0.5n
C9: cap; 2p
C10: cap; 0.1p
C11: cap; {Cb}; Rser=0.2 Lser=0.7n
C12: cap; 15p
C13: cap; 10µ; Rser=0.02 Lser=1.5n
C14: cap; 100n; Rser=0.05 Lser=0.7n
C15: cap; 10µ; Rser=0.02 Lser=1.5n
C16: cap; 100n; Rser=0.05 Lser=0.7n
R1: res; 57.6k
R2: res; 10k
R3: res; 10k
R4: res; 976k
R5: res; 61.9k
R6: res; 1k
R9: res; {Rg}
R10: res; {R16}
U1: G6K_SPDT
U2: LMH6642
U3: OPA354
U4: OPA354
V1: voltage; {Vdc}; Rser=50 Cpar=100p
V2: voltage; 3.3
V4: voltage; 3.3
V7: voltage; PULSE(0 5 0.5m 1u 1u 0.4m 1m 100)
V8: voltage; 5; Rser=0.1
Named nets: 0, V_out, V+, PULSE, 5+, Vref, N, bufo, inm, out5, mid, v33
.param Rg=1G
.options plotwinsize=0 numdgt=15 noopiter gminsteps=0
.nodeset V(5+)=5 V(v33)=3.3 V(n)=1.65 V(bufo)=1.65 V(vref)=1.65 V(mid)=1.65 V(inm)=1.65 V(out5)=1.65 V(v_out)=1.65
.param R16=47 Cb=150p Radc=200 Vdc=21.5
.tran 0 4u 0 1n
S_adc V_out adcn smp 0 SW1
V_smp smp 0 PULSE(0 1 1u 1n 1n 40.67n 250n)
R_adc adcn adcx {Radc}
C_adc adcx 0 5p
B_rst rstc 0 V=1-V(smp)
S_rst adcx 0 rstc 0 SW1
.model SW1 SW(Ron=1 Roff=1G Vt=0.5 Vh=0.05)
.meas TRAN vpin FIND V(v_out) AT 0.9u
.meas TRAN vend FIND V(adcx) AT 2.2912u
.meas TRAN err_mV PARAM (vend-vpin)*1000
.meas TRAN err_LSB PARAM (vend-vpin)/0.00080566
ADC SETTLING TEST (STM32G474, 12 bit, 2.5 cycles @ 60 MHz = 41.67 ns every 250 ns = 4 Msps)
The ADC input is a switch (S_adc) + R_adc + C_adc = 5 pF. Before every window the sample capacitor is
emptied to 0 V (S_rst), so every window is a 0 V -> V(v_out) step (worst case).
Read err_mV / err_LSB in View > SPICE Error Log (window 6: t = 2.25 us ... 2.2912 us).
Change R16 (R10), Cb (C11), Radc, Vdc in the .param line. Vdc = 21.5 gives a 2.3 V step at the pin (G = 1).
Plot V(v_out), V(adcx), V(smp). R_adc is NOT in the datasheet table: 100..500 ohm changes little.
