Czolsonn/Oscyloskop/Symulacje/_archiwum_stary_uklad/Analog Front End_supply.asc

C2: cap; 3.3p; Rser=1 Lser=0.5n
C3: cap; 82p; Rser=0.3 Lser=0.7n
C4: cap; 0.1µ; V=100 Irms=0 Rser=0.03 Lser=0.8n Rpar=1G
C5: cap; 27p; Rser=1 Lser=1n
C6: cap; 3p
C7: cap; 0.15p
C8: cap; 3.7p; Rser=0.2 Lser=0.5n
C9: cap; 2p
C10: cap; 0.1p
C11: cap; 150p; Rser=0.2 Lser=0.7n
C12: cap; 15p
C13: cap; 10µ; Rser=0.02 Lser=1.5n
C14: cap; 100n; Rser=0.05 Lser=0.7n
C15: cap; 10µ; Rser=0.02 Lser=1.5n
C16: cap; 100n; Rser=0.05 Lser=0.7n
Ca1: cap; 10n; Rser=50m Lser=0.5n
Ca2: cap; 1µ; Rser=5m Lser=0.7n
Ca3: cap; 1µ; Rser=5m Lser=0.7n
Cb: cap; {Cbias}
Cin: cap; 10µ; Rser=5m Lser=1n
Cmcu: cap; 6.2µ; Rser=3m Lser=0.5n
Co3: cap; 1µ; Rser=5m Lser=0.7n
Co5: cap; 22µ; Rser={Resr5} Lser=1n
Co5b: cap; 1µ; Rser=5m Lser=0.7n
FB1: BLM18AG102; L={Lbead} Rdc={Rbead}
R1: res; 52.3k
R1a: res; 5.23k
R2: res; 10k
R3: res; 10k
R4: res; 976k
R5: res; 61.9k
R6: res; 1k
R9: res; {Rg}
R10: res; 100
Rd: res; {Rdamp}
U1: G6K_SPDT
U2: LMH6642
U3: OPA354
U4: OPA354
U6: TLV1117_50
U7: AP2112K_33
V1: voltage; SINE(0 40 50k); AC 0; Rser=50 Cpar=100p
V7: voltage; PULSE(0 5 0.5m 1u 1u 0.4m 1m 100)
Vbat: voltage; {Vbat}; AC {kBat*1m}; Rser=0.15
Vrip: voltage; 0; AC {kRail*1m}
Named nets: 0, V_out, PULSE, 5+, Vref, N, bufo, inm, out5, mid, v33, vbat, v33reg, vdda
.param Rg=52.3
.options plotwinsize=0 numdgt=15 noopiter gminsteps=0 abstol=1e-10 reltol=0.003 vntol=1e-5
.nodeset V(vbat)=7.4 V(v33reg)=3.3 V(vdda)=3.3 V(5+)=5 V(v33)=3.3 V(n)=1.65 V(bufo)=1.65 V(vref)=1.65 V(mid)=1.65 V(inm)=1.65 V(out5)=1.65 V(v_out)=1.65
.param Vbat=7.4 kRail=1 kLoad=0 k5=0 kBat=0
.param Cbias=10u Rdamp=3.3 Lbead=6u Rbead=0.35 Resr5=5m
.ac dec 50 1 10Meg
I_dig v33reg 0 DC 0.12 AC {kLoad*1m}
I_rel 5+ 0 DC 0.06 AC {k5*1m}
I_ana vdda 0 DC 3m
B_code code 0 V=4096*V(v_out)/V(vdda)
.meas AC lsb_10Hz FIND mag(V(code)) AT 10
.meas AC lsb_1k FIND mag(V(code)) AT 1k
.meas AC lsb_10k FIND mag(V(code)) AT 10k
.meas AC lsb_50k FIND mag(V(code)) AT 50k
.meas AC lsb_max MAX mag(V(code))
.meas AC v33_1k FIND mag(V(v33)) AT 1k
.meas AC vdda_1k FIND mag(V(vdda)) AT 1k
.meas AC vdda_max MAX mag(V(vdda))
SUPPLY / VDDA TEST.  Battery -> TLV1117-5.0 -> 5 V -> AP2112K-3.3 -> 3.3 V -> ferrite FB1 -> VDDA (= ADC reference).
V(code) = ADC reading in LSB (4096*V(v_out)/V(vdda)). In the .ac run it is the change in LSB for the excitation below.
Pick ONE excitation by setting its k to 1 (the others 0):
  kRail=1 : 1 mV ripple on the 3.3 V rail (source Vrip)      -> V(code) = LSB per mV of rail ripple
  kLoad=1 : 1 mA load-current ripple on the 3.3 V rail (MCU)  -> V(code) = LSB per mA, V(v33) = rail impedance in Ohm*1m
  k5=1    : 1 mA load-current ripple on the 5 V rail (relays)   kBat=1 : 1 mV ripple on the battery
Cbias: 1p = bias fed straight from 3.3 V (as in KiCad now); 10u = filtered bias (proposed fix; R1a 5.23k + R1 52.3k replace the 57.6k).
Rdamp: resistor in series with the ferrite (1m = none). Resr5: ESR of the 22 uF on the 5 V rail. Rg sets the gain.
Noise: replace .ac by   .noise V(code) V1 dec 30 1 10Meg   and integrate V(onoise) (Ctrl+click the trace) -> LSB rms.
Regulators are BEHAVIOURAL models from the datasheets (supply_models.lib), not vendor models.
