Czolsonn/Oscyloskop/Symulacje/_archiwum_stary_uklad/zz_m.asc

B1: bv; V=0
C2: cap; 3.3p; Rser=1 Lser=0.5n
C3: cap; 82p; Rser=0.3 Lser=0.7n
C4: cap; 0.1µ; V=100 Irms=0 Rser=0.03 Lser=0.8n Rpar=1G
C5: cap; 33.7p; Rser=1 Lser=1n
C6: cap; 3p
C7: cap; 0.15p
C8: cap; 3.7p; Rser=0.2 Lser=0.5n
C9: cap; 2p
C10: cap; 0.1p
C11: cap; 150p; Rser=0.2 Lser=0.7n
C12: cap; 15p
C13: cap; 10u; Rser=0.02 Lser=1.5n
C14: cap; 100n; Rser=0.05 Lser=0.7n
C15: cap; 10u; Rser=0.02 Lser=1.5n
C16: cap; 100n; Rser=0.05 Lser=0.7n
Cb: cap; 100µ; Rser=0.02 Lser=1.5n
R1: res; 57.6k
R1a: res; 499
R2: res; 10k
R3: res; 10k
R4: res; 976k
R5: res; 61.9k
R6: res; 1k
R9: res; {Rg}
R10: res; 47
Rdac: res; {Rdac}
U1: G6K_SPDT
U2: LMH6642
U3: OPA354
U4: OPA354
V1: voltage; 0; AC 1; Rser=50 Cpar=100p
V4: voltage; 3.3
V7: voltage; {5*kAC}
V8: voltage; 5; Rser=0.1
Vdac: voltage; {Vdac}
Named nets: 0, V_out, v33, dac, in, PULSE, 5+, Vref, N, bufo, inm, out5, mid
.options plotwinsize=0 numdgt=15 noopiter gminsteps=0 abstol=1e-10 reltol=0.003 vntol=1e-5
.nodeset V(5+)=5 V(v33)=3.3 V(n)=1.65 V(bufo)=1.65 V(vref)=1.65 V(mid)=1.65 V(inm)=1.65 V(out5)=1.65 V(v_out)=1.65
.param sig=0 Vsig=0
.param Rdac=511k
.param Vdac=if(kAC>0.5,0.715,1.576)
.param Rg=1G
.param kAC=0
.ac dec 100 100 300Meg
.meas AC gmid FIND mag(V(v_out)) AT 1k
.meas AC g100k FIND mag(V(v_out)) AT 100k
.meas AC g1M FIND mag(V(v_out)) AT 1Meg
.meas AC f3db WHEN mag(V(v_out))=gmid/sqrt(2) FALL=1
.meas AC pk MAX mag(V(out5))
.meas AC a1k FIND mag(V(out5)) AT 1k
FINAL 2 - FREQUENCY RESPONSE, all four gains, DC and AC coupling (8 curves in one run).
Run, then plot V(v_out). Right-click the plot > Select Steps to show only some curves.
Steps: Rg = 52.3 / 110 / 499 / 1G  ->  G = 20.12 / 10.09 / 3.004 / 1;  kAC = 0 DC coupling, 1 AC coupling.
Results per step: View > SPICE Error Log (gmid, g1M, f3db, f3db_low). f3db_low exists only in AC mode (about 1.6 Hz).
