Czolsonn/Oscyloskop/Symulacje/_archiwum_stary_uklad/Analog Front End_MC_AC.asc

C2: cap; {mc(3.3p,tolC)}; Rser=1 Lser=0.5n
C3: cap; {mc(82p,tolC)}; Rser=0.3 Lser=0.7n
C4: cap; {mc(0.1u,0.1)}; V=100 Irms=0 Rser=0.03 Lser=0.8n Rpar=1G
C5: cap; {mc(27p,tolC)}; Rser=1 Lser=1n
C6: cap; {mc(3p,tolS)}
C7: cap; {mc(0.15p,tolS)}
C8: cap; {mc(3.7p,tolC)}; Rser=0.2 Lser=0.5n
C9: cap; {mc(2p,tolS)}
C10: cap; 0.1p
C11: cap; 150p; Rser=0.2 Lser=0.7n
C12: cap; 15p
C13: cap; 10u; Rser=0.02 Lser=1.5n
C14: cap; 100n; Rser=0.05 Lser=0.7n
C15: cap; 10u; Rser=0.02 Lser=1.5n
C16: cap; 100n; Rser=0.05 Lser=0.7n
R1: res; {mc(57.6k,tolR)}
R2: res; {mc(10k,tolR)}
R3: res; {mc(10k,tolR)}
R4: res; {mc(976k,tolR)}
R5: res; {mc(61.9k,tolR)}
R6: res; {mc(1k,tolR)}
R9: res; {mc(Rg,tolR)}
R10: res; 100
U1: G6K_SPDT
U2: LMH6642
U3: OPA354
U4: OPA354
V1: voltage; SINE(0 40 50k); AC 1; Rser=50 Cpar=100p
V2: voltage; 3.3
V4: voltage; 3.3
V7: voltage; {5*kAC}
V8: voltage; 5; Rser=0.1
Named nets: 0, V_out, V+, PULSE, 5+, Vref, N, bufo, inm, out5, mid, v33
.param Rg=1G
.options plotwinsize=0 numdgt=15 noopiter gminsteps=0 abstol=1e-10 reltol=0.003 vntol=1e-5
.nodeset V(5+)=5 V(v33)=3.3 V(n)=1.65 V(bufo)=1.65 V(vref)=1.65 V(mid)=1.65 V(inm)=1.65 V(out5)=1.65 V(v_out)=1.65
.param tolR=0.001 tolC=0.05 tolS=0.3 kAC=0
.step param run 1 30 1
.ac dec 20 1k 50Meg
.meas AC gmid FIND mag(V(v_out)) AT 1k
.meas AC g100k FIND mag(V(v_out)) AT 100k
.meas AC g1M FIND mag(V(v_out)) AT 1Meg
.meas AC f3db WHEN mag(V(v_out))=gmid/sqrt(2) FALL=1
.meas AC r100k PARAM g100k/gmid
.meas AC r1M PARAM g1M/gmid
