Czolsonn/Oscyloskop/Symulacje/_archiwum_stary_uklad/plot's/Final/Analog Front End_final_1_signals.asc

B1: bv; V=if({sig}==1, 2*sin(2*pi*1k*time), if({sig}==2, 40*sin(2*pi*1Meg*time), if({sig}==3, 40*tanh(350*sin(2*pi*1k*time)), if({sig}==4, 2.5+2.5*tanh(350*sin(2*pi*100k*time)), 12+sin(2*pi*10k*time)))))
C2: cap; 3.3p; Rser=1 Lser=0.5n
C3: cap; 82p; Rser=0.3 Lser=0.7n
C4: cap; 0.1µ; V=100 Irms=0 Rser=0.03 Lser=0.8n Rpar=1G
C5: cap; 33.7p; Rser=1 Lser=1n
C6: cap; 3p
C7: cap; 0.15p
C8: cap; 3.7p; Rser=0.2 Lser=0.5n
C9: cap; 2p
C10: cap; 0.1p
C11: cap; 150p; Rser=0.2 Lser=0.7n
C12: cap; 15p
C13: cap; 10u; Rser=0.02 Lser=1.5n
C14: cap; 100n; Rser=0.05 Lser=0.7n
C15: cap; 10u; Rser=0.02 Lser=1.5n
C16: cap; 100n; Rser=0.05 Lser=0.7n
Cb: cap; 100µ; Rser=0.02 Lser=1.5n
R1: res; 57.6k
R1a: res; 499
R2: res; 10k
R3: res; 10k
R4: res; 976k
R5: res; 61.9k
R6: res; 1k
R9: res; {Rg}
R10: res; 47
Rdac: res; {Rdac}
U1: G6K_SPDT
U2: LMH6642
U3: OPA354
U4: OPA354
V1: voltage; 0; AC 1; Rser=50 Cpar=100p
V4: voltage; 3.3
V7: voltage; {5*kAC}
V8: voltage; 5; Rser=0.1
Vdac: voltage; {Vdac}
Named nets: 0, V_out, v33, dac, in, PULSE, 5+, Vref, N, bufo, inm, out5, mid
.options plotwinsize=0 numdgt=15 noopiter gminsteps=0 abstol=1e-10 reltol=0.003 vntol=1e-5
.nodeset V(5+)=5 V(v33)=3.3 V(n)=1.65 V(bufo)=1.65 V(vref)=1.65 V(mid)=1.65 V(inm)=1.65 V(out5)=1.65 V(v_out)=1.65
.param sig=1 kAC=0
.param Rdac=511k
.param Vdac=if(kAC>0.5,0.715,1.576)
.param Rg=table(sig, 1,52.3, 2,1G, 3,1G, 4,110, 5,if(kAC>0.5,52.3,499))
.param tstop=table(sig, 1,3m, 2,5u, 3,2m, 4,30u, 5,300u)
.param Vsig=0
.tran 0 {tstop} 0 {tstop/20000}
.meas TRAN vo_max MAX V(v_out)
.meas TRAN vo_min MIN V(v_out)
.meas TRAN vo_avg AVG V(v_out)
.meas TRAN vo_pp PARAM vo_max-vo_min
.meas TRAN vin_pp PP V(in)
FINAL 1 - OUTPUT FOR EXAMPLE INPUT SIGNALS (transient).   Set  sig = 1..5  and  kAC = 0 (DC coupling) or 1 (AC coupling), then Run.
Plot V(in) (the BNC input) and V(v_out) (the ADC pin). Gain and stop time are picked automatically from sig:
  sig=1  sine 1 kHz, 2 V amplitude            G=20   (small signal, highest gain)
  sig=2  sine 1 MHz, 40 V amplitude           G=1    (top of the band, large signal)
  sig=3  square 1 kHz, +-40 V, 1 us edges     G=1    (shows the divider compensation: flat top = OK)
  sig=4  logic square 100 kHz, 0..5 V         G=10   (signal with a DC part: DC mode keeps it, AC mode removes it)
  sig=5  12 V DC + 1 V sine 10 kHz (ripple)   G=3 in DC mode, G=20 in AC mode  (AC mode removes the 12 V, so more gain can be used)
All sources start at their mean value, so the AC-coupling capacitor is already charged (no 0.5 s settling to wait for).
Rdac/Vdac = DAC offset trim (see FINAL 3). The BAT54S clamp is not modelled: above 3.3 V the real pin is clamped.
