Czolsonn/Oscyloskop/Symulacje/_archiwum_stary_uklad/plot's/Final/Analog Front End_final_3_offset_trim.asc

B1: bv; V=if({sig}==1, 2*sin(2*pi*1k*time), if({sig}==2, 40*sin(2*pi*1Meg*time), if({sig}==3, 40*tanh(350*sin(2*pi*1k*time)), if({sig}==4, 2.5+2.5*tanh(350*sin(2*pi*100k*time)), 12+sin(2*pi*10k*time)))))
C2: cap; 3.3p; Rser=1 Lser=0.5n
C3: cap; 82p; Rser=0.3 Lser=0.7n
C4: cap; 0.1µ; V=100 Irms=0 Rser=0.03 Lser=0.8n Rpar=1G
C5: cap; 33.7p; Rser=1 Lser=1n
C6: cap; 3p
C7: cap; 0.15p
C8: cap; 3.7p; Rser=0.2 Lser=0.5n
C9: cap; 2p
C10: cap; 0.1p
C11: cap; 150p; Rser=0.2 Lser=0.7n
C12: cap; 15p
C13: cap; 10u; Rser=0.02 Lser=1.5n
C14: cap; 100n; Rser=0.05 Lser=0.7n
C15: cap; 10u; Rser=0.02 Lser=1.5n
C16: cap; 100n; Rser=0.05 Lser=0.7n
Cb: cap; 100µ; Rser=0.02 Lser=1.5n
R1: res; 57.6k
R1a: res; 499
R2: res; 10k
R3: res; 10k
R4: res; 976k
R5: res; 61.9k
R6: res; 1k
R9: res; {Rg}
R10: res; 47
Rdac: res; {Rdac}
U1: G6K_SPDT
U2: LMH6642
U3: OPA354
U4: OPA354
V1: voltage; 0; AC 1; Rser=50 Cpar=100p
V4: voltage; 3.3
V7: voltage; {5*kAC}
V8: voltage; 5; Rser=0.1
Vdac: voltage; {Vdac}
Named nets: 0, V_out, v33, dac, in, PULSE, 5+, Vref, N, bufo, inm, out5, mid
.options plotwinsize=0 numdgt=15 noopiter gminsteps=0 abstol=1e-10 reltol=0.003 vntol=1e-5
.nodeset V(5+)=5 V(v33)=3.3 V(n)=1.65 V(bufo)=1.65 V(vref)=1.65 V(mid)=1.65 V(inm)=1.65 V(out5)=1.65 V(v_out)=1.65
.param sig=1 Vsig=0
.step param trim list 0 1
.step param kAC list 0 1
.param Rdac=if(trim>0.5,511k,1G)
.param Vdac=if(kAC>0.5,0.715,1.576)
.param Rg=52.3
.tran 0 3m 0 150n
.meas TRAN vo_avg AVG V(v_out)
.meas TRAN vo_max MAX V(v_out)
.meas TRAN vo_min MIN V(v_out)
.meas TRAN vn_avg AVG V(n)
.meas TRAN zero_err_mV PARAM (vo_avg-1.65)*1000
.meas TRAN zero_err_LSB PARAM (vo_avg-1.65)/0.00080566
FINAL 3 - OFFSET AT NODE N AND ITS CORRECTION WITH THE DAC.   Input: sine 1 kHz, 2 V amplitude, G = 20.
trim = 0 : no trim resistor (Rdac = 1G)  = "before".     trim = 1 : Rdac = 511k from the DAC voltage Vdac to node N  = "after".
kAC = 0 DC coupling, 1 AC coupling.  4 curves: plot V(v_out). The zero line should be 1.65 V (ADC mid-scale).
Vdac (a voltage source standing in for the STM32 DAC, PA4): 1.576 V in DC mode, 0.715 V in AC mode.
Results: View > SPICE Error Log -> vo_avg, zero_err_mV, zero_err_LSB for each step.
The BAT54S clamp is not modelled: in the "before / AC" curve the real ADC pin would be clipped at about 3.3 V.
