Czolsonn/Oscyloskop/KiCad/Oscyloskop/Oscyloskop.kicad_pcb

## KiCad design KiCad/Oscyloskop/Oscyloskop.kicad_pcb (2026-10-21)

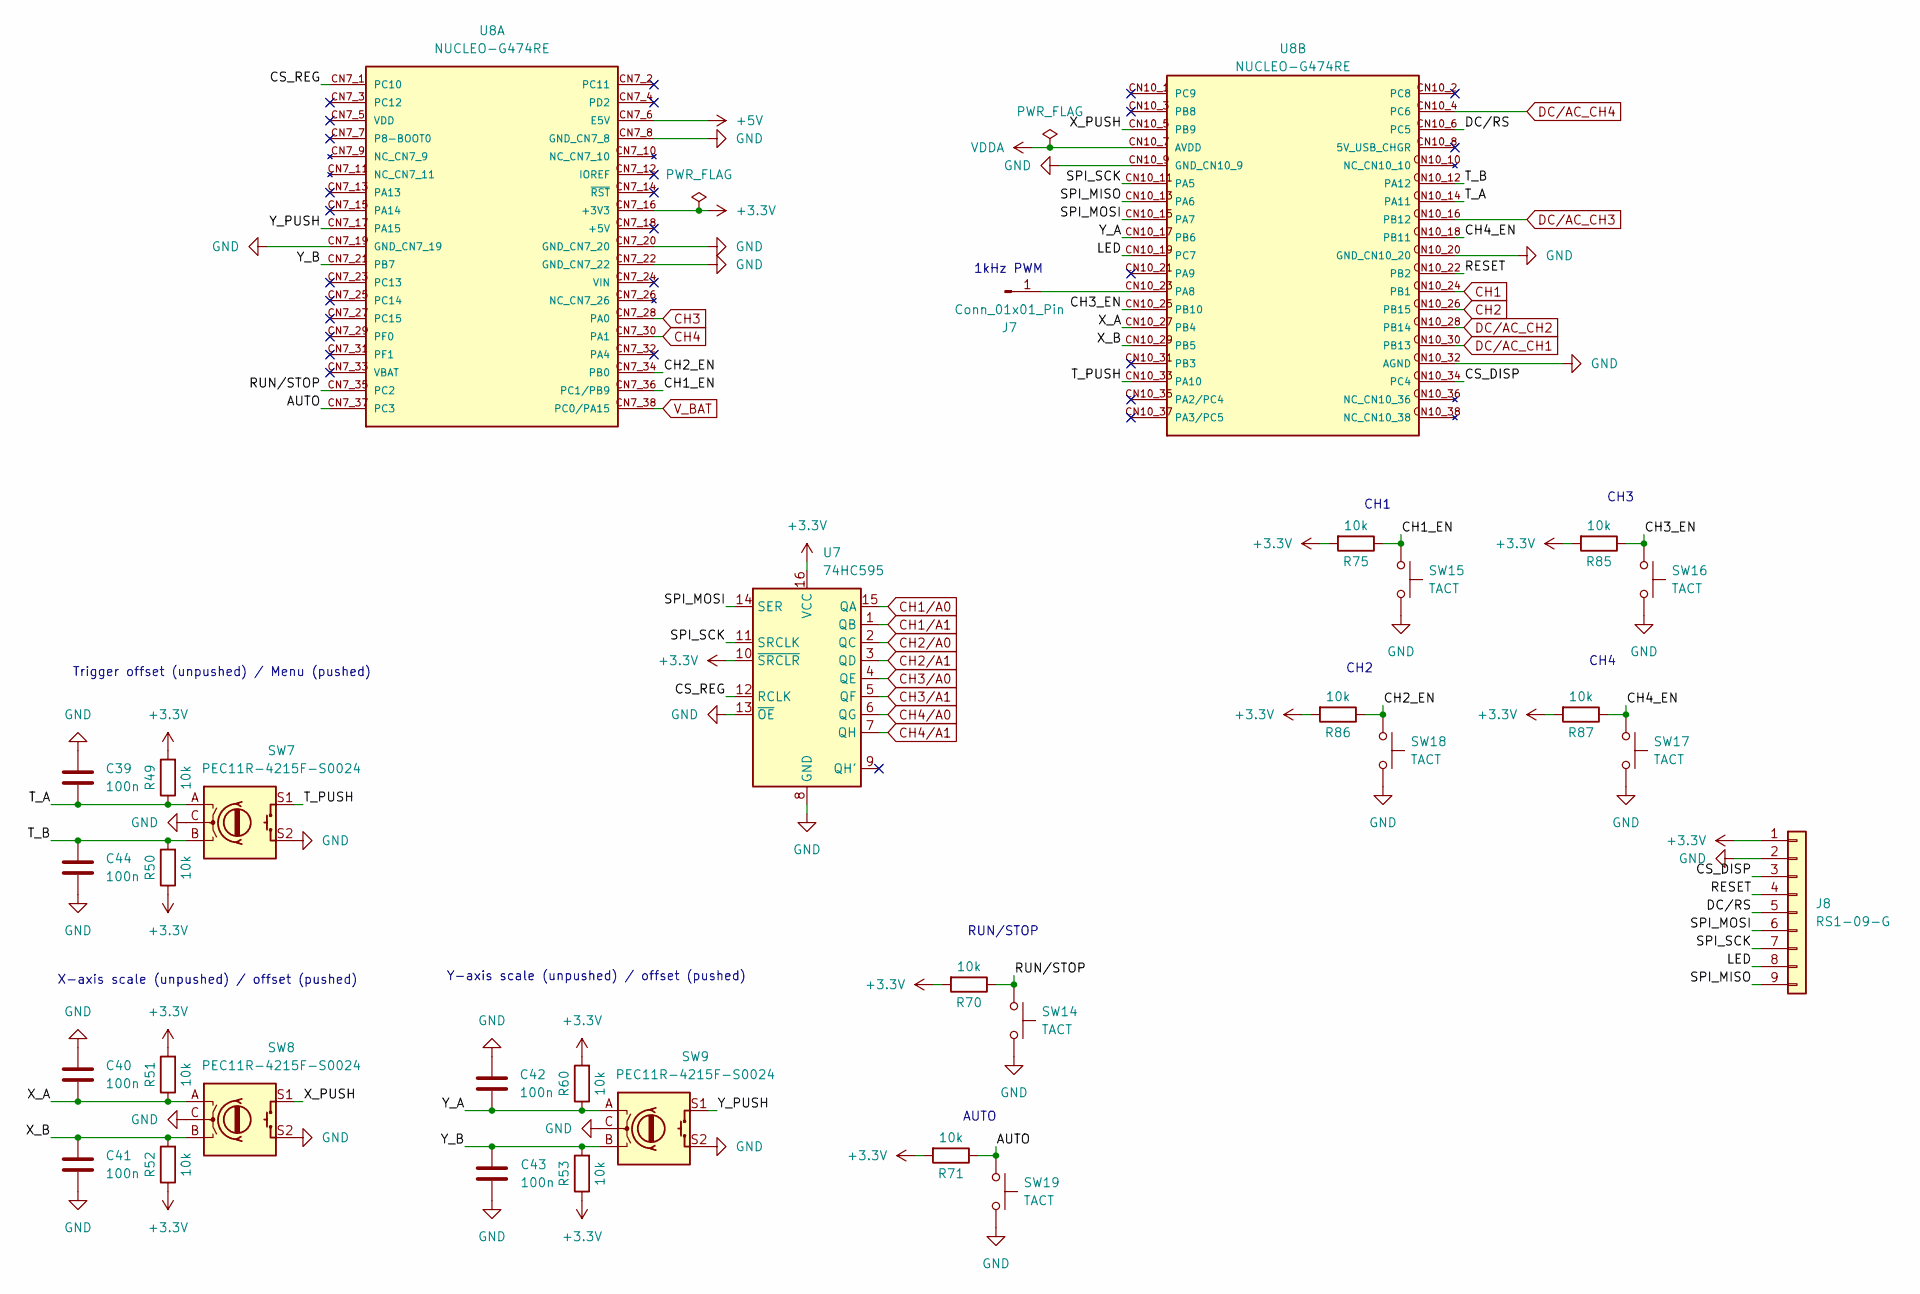
[picture p24: schematic nucleo.kicad_sch]

Parts:
C39, C40, C41, C42, C43, C44: 100n; C_0603_1608Metric
J7: Conn_01x01_Pin; PinHeader_1x01_P2.54mm_Vertical
J8: RS1-09-G; PinSocket_1x09_P2.54mm_Vertical
R49, R50, R51, R52, R53, R60, R70, R71, R75, R85, R86, R87: 10k; R_0603_1608Metric
SW7, SW8, SW9: PEC11R-4215F-S0024; RotaryEncoder_EC11_Switch_Vertical_Generic
SW14, SW15, SW16, SW17, SW18, SW19: TACT; SW_PUSH-12mm
U7: 74HC595; TSSOP-16_4.4x5mm_P0.65mm
U8: NUCLEO-G474RE; MODULE_NUCLEO-G474RE; PARTREV 17

Connections:
+3.3V: J8.1, R49.2, R50.1, R51.2, R52.1, R53.1, R60.2, R70.2, R71.2, R75.2, R85.2, R86.2, R87.2, U7.10 (~SRCLR), U7.16 (VCC), U8.CN7_16 (+3V3); also elsewhere on the board
+5V: U8.CN7_6 (E5V); also elsewhere on the board
/Nucleo STM32/AUTO: R71.1, SW19.1, U8.CN7_37 (PC3)
/Nucleo STM32/CH1_EN: R75.1, SW15.1, U8.CN7_36 (PC1/PB9)
/Nucleo STM32/CH2_EN: R86.1, SW18.1, U8.CN7_34 (PB0)
/Nucleo STM32/CH3_EN: R85.1, SW16.1, U8.CN10_25 (PB10)
/Nucleo STM32/CH4_EN: R87.1, SW17.1, U8.CN10_18 (PB11)
/Nucleo STM32/CS_DISP: J8.3, U8.CN10_34 (PC4)
/Nucleo STM32/CS_REG: U7.12 (RCLK), U8.CN7_1 (PC10)
/Nucleo STM32/DC/RS: J8.5, U8.CN10_6 (PC5)
/Nucleo STM32/LED: J8.8, U8.CN10_19 (PC7)
/Nucleo STM32/RESET: J8.4, U8.CN10_22 (PB2)
/Nucleo STM32/RUN/STOP: R70.1, SW14.1, U8.CN7_35 (PC2)
/Nucleo STM32/SPI_MISO: J8.9, U8.CN10_13 (PA6)
/Nucleo STM32/SPI_MOSI: J8.6, U7.14 (SER), U8.CN10_15 (PA7)
/Nucleo STM32/SPI_SCK: J8.7, U7.11 (SRCLK), U8.CN10_11 (PA5)
/Nucleo STM32/T_A: C39.1, R49.1, SW7.A, U8.CN10_14 (PA11)
/Nucleo STM32/T_B: C44.2, R50.2, SW7.B, U8.CN10_12 (PA12)
/Nucleo STM32/T_PUSH: SW7.S1, U8.CN10_33 (PA10)
/Nucleo STM32/X_A: C40.1, R51.1, SW8.A, U8.CN10_27 (PB4)
/Nucleo STM32/X_B: C41.2, R52.2, SW8.B, U8.CN10_29 (PB5)
/Nucleo STM32/X_PUSH: SW8.S1, U8.CN10_5 (PB9)
/Nucleo STM32/Y_A: C42.1, R60.1, SW9.A, U8.CN10_17 (PB6)
/Nucleo STM32/Y_B: C43.2, R53.2, SW9.B, U8.CN7_21 (PB7)
/Nucleo STM32/Y_PUSH: SW9.S1, U8.CN7_17 (PA15)
CH1: U8.CN10_24 (PB1); also elsewhere on the board
CH1/A0: U7.15 (QA); also elsewhere on the board
CH1/A1: U7.1 (QB); also elsewhere on the board
CH2: U8.CN10_26 (PB15); also elsewhere on the board
CH2/A0: U7.2 (QC); also elsewhere on the board
CH2/A1: U7.3 (QD); also elsewhere on the board
CH3: U8.CN7_28 (PA0); also elsewhere on the board
CH3/A0: U7.4 (QE); also elsewhere on the board
CH3/A1: U7.5 (QF); also elsewhere on the board
CH4: U8.CN7_30 (PA1); also elsewhere on the board
CH4/A0: U7.6 (QG); also elsewhere on the board
CH4/A1: U7.7 (QH); also elsewhere on the board
DC/AC_CH1: U8.CN10_30 (PB13); also elsewhere on the board
DC/AC_CH2: U8.CN10_28 (PB14); also elsewhere on the board
DC/AC_CH3: U8.CN10_16 (PB12); also elsewhere on the board
DC/AC_CH4: U8.CN10_4 (PC6); also elsewhere on the board
GND: C39.2, C40.2, C41.1, C42.2, C43.1, C44.1, J8.2, SW7.C, SW7.S2, SW8.C, SW8.S2, SW9.C, SW9.S2, SW14.2, SW15.2, SW16.2, SW17.2, SW18.2, SW19.2, U7.8 (GND), U7.13 (~OE), U8.CN7_8 (GND_CN7_8), U8.CN7_19 (GND_CN7_19), U8.CN7_20 (GND_CN7_20), U8.CN7_22 (GND_CN7_22), U8.CN10_9 (GND_CN10_9), U8.CN10_20 (GND_CN10_20), U8.CN10_32 (AGND); also elsewhere on the board
unnamed: J7.1 (Pin_1_1), U8.CN10_23 (PA8)
VDDA: U8.CN10_7 (AVDD); also elsewhere on the board
V_BAT: U8.CN7_38 (PC0/PA15); also elsewhere on the board

Notes on the sheet:
Y-axis scale (unpushed) / offset (pushed)
CH2
RUN/STOP
CH1
1kHz PWM
AUTO
CH4
X-axis scale (unpushed) / offset (pushed)
Trigger offset (unpushed) / Menu (pushed)
CH3

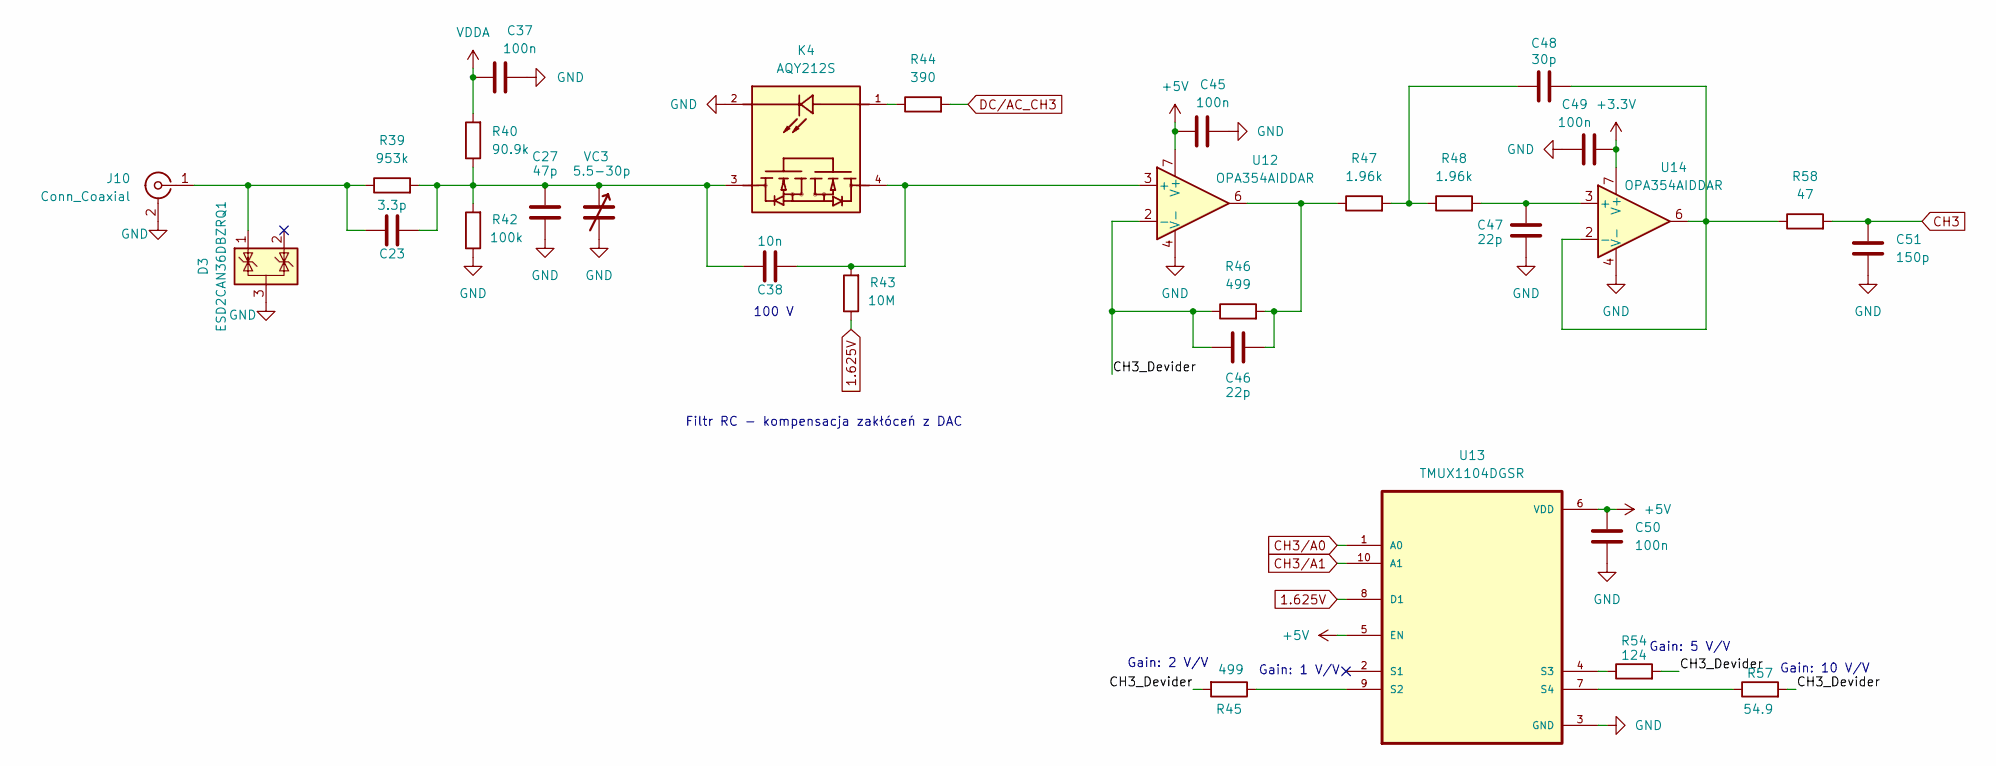
[picture p25: schematic analog_input_ch3.kicad_sch]

Parts:
C23: 3.3p; C_0603_1608Metric
C27: 47p; C_0603_1608Metric
C37, C45, C49, C50: 100n; C_0603_1608Metric
C38: 10n; C_0603_1608Metric
C46, C47: 22p; C_0603_1608Metric
C48: 30p; C_0603_1608Metric
C51: 150p; C_0603_1608Metric
D3: ESD2CAN36DBZRQ1; SOT-23
J10: Conn_Coaxial; BNC_Amphenol_B6252HB-NPP3G-50_Horizontal
K4: AQY212S; SOP-4_6.5x2.54; PART_NUMBER_(LCSC) C1525231
R39: 953k; R_0805_2012Metric
R40: 90.9k; R_0805_2012Metric
R42: 100k; R_0805_2012Metric
R43: 10M; R_0603_1608Metric
R44: 390; R_0603_1608Metric
R45, R46: 499; R_0603_1608Metric
R47, R48: 1.96k; R_0603_1608Metric
R54: 124; R_0603_1608Metric
R57: 54.9; R_0603_1608Metric
R58: 47; R_0603_1608Metric
U12, U14: OPA354AIDDAR; SOIC-8-1EP_3.9x4.9mm_P1.27mm_EP2.29x3mm
U13: TMUX1104DGSR; SOP50P490X110-10N
VC3: 5.5-30p; C_Trimmer_Voltronics_JZ

Connections:
1.625V: R43.1, U13.8 (D1); also elsewhere on the board
+3.3V: C49.2, U14.7 (V+); also elsewhere on the board
+5V: C45.1, C50.2, U12.7 (V+), U13.5 (EN), U13.6 (VDD); also elsewhere on the board
/Analog Input CH3/CH3_Devider: C46.2, R45.2, R46.1, R54.2, R57.2, U12.2 (-)
CH3: C51.1, R58.2; also elsewhere on the board
CH3/A0: U13.1 (A0); also elsewhere on the board
CH3/A1: U13.10 (A1); also elsewhere on the board
DC/AC_CH3: R44.2; also elsewhere on the board
GND: C27.1, C37.2, C45.2, C47.1, C49.1, C50.1, C51.2, D3.3 (A), J10.2 (Ext), K4.2, R42.1, U12.4 (V-), U12.9 (V-), U13.3 (GND), U14.4 (V-), U14.9 (V-), VC3.2; also elsewhere on the board
unnamed: C23.2, C27.2, C38.1, K4.3, R39.2, R40.1, R42.2, VC3.1
unnamed: C46.1, R46.2, R47.1, U12.6
unnamed: C48.1, R47.2, R48.1
unnamed: C23.1, D3.1 (K), J10.1 (In), R39.1
unnamed: K4.1, R44.1
unnamed: C38.2, K4.4, R43.2, U12.3 (+)
unnamed: R45.1, U13.9 (S2)
unnamed: R54.1, U13.4 (S3)
unnamed: R57.1, U13.7 (S4)
unnamed: C47.2, R48.2, U14.3 (+)
unnamed: C48.2, R58.1, U14.2 (-), U14.6
VDDA: C37.1, R40.2; also elsewhere on the board

Notes on the sheet:
Filtr RC - kompensacja zakłóceń z DAC
100 V
Gain: 2 V/V
Gain: 5 V/V
Gain: 1 V/V
Gain: 10 V/V

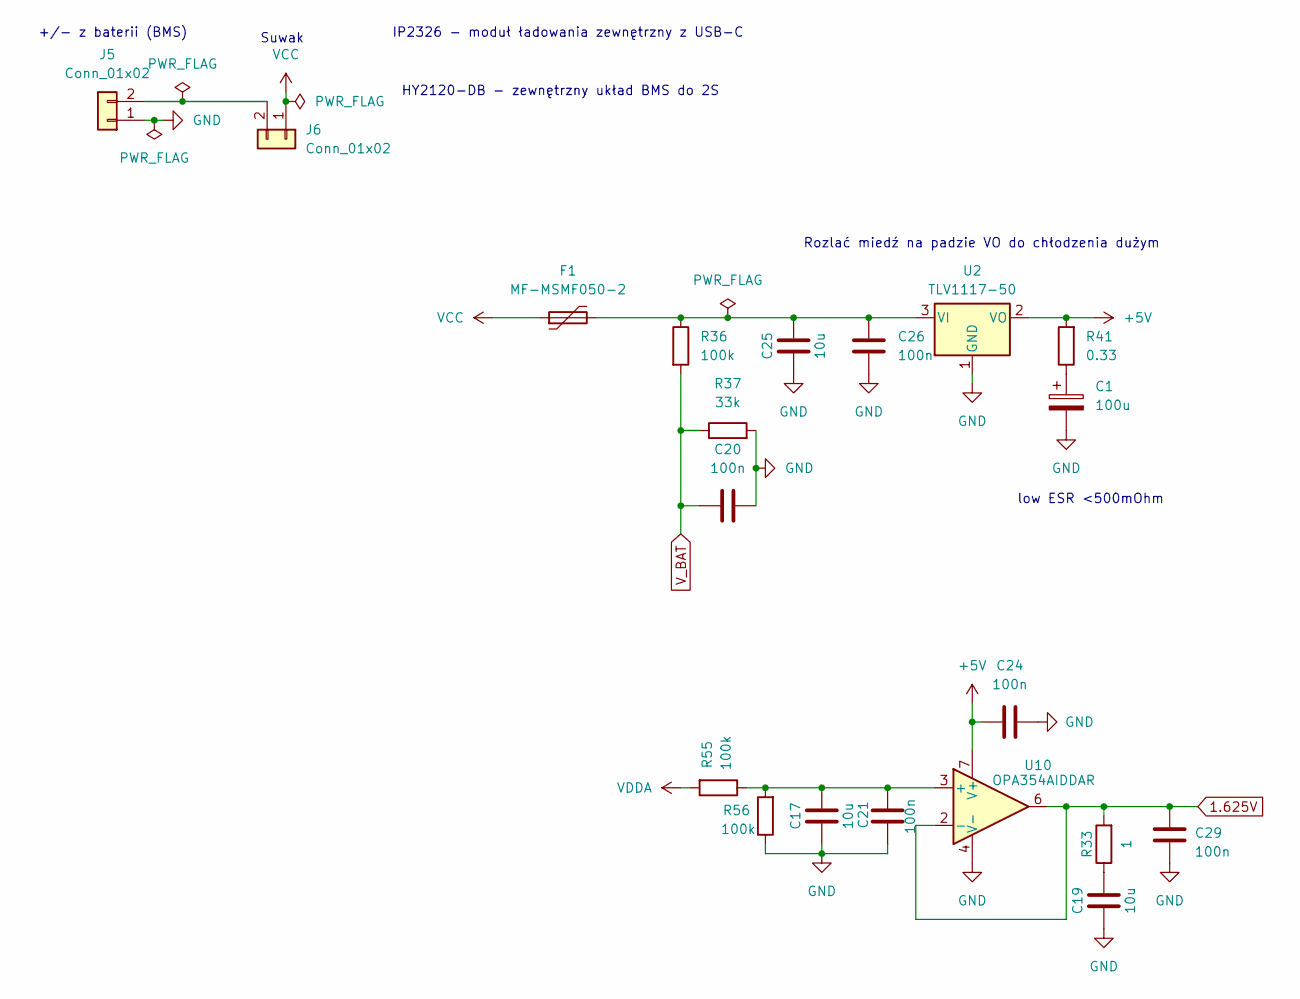
[picture p26: schematic power_input.kicad_sch]

Parts:
C1: 100u; CP_Elec_6.3x5.4
C17, C19, C25: 10u; C_0805_2012Metric
C20, C21, C24, C26, C29: 100n; C_0603_1608Metric
F1: MF-MSMF050-2; Fuse_1812_4532Metric
J5, J6: Conn_01x02; PinHeader_1x02_P2.54mm_Vertical
R33: 1; R_0603_1608Metric
R36: 100k; R_0603_1608Metric
R37: 33k; R_0603_1608Metric
R41: 0.33; R_0805_2012Metric
R55, R56: 100k; R_0805_2012Metric
U2: TLV1117-50; SOT-223-3_TabPin2
U10: OPA354AIDDAR; SOIC-8-1EP_3.9x4.9mm_P1.27mm_EP2.29x3mm

Connections:
1.625V: C29.2, R33.2, U10.2 (-), U10.6; also elsewhere on the board
+5V: C24.1, R41.2, U2.2 (VO), U10.7 (V+); also elsewhere on the board
GND: C1.2, C17.2, C19.2, C20.2, C21.2, C24.2, C25.2, C26.1, C29.1, J5.1, R37.2, R56.1, U2.1 (GND), U10.4 (V-), U10.9 (V-); also elsewhere on the board
unnamed: C1.1, R41.1
unnamed: C19.1, R33.1
unnamed: J5.2, J6.2
unnamed: C25.1, C26.2, F1.2, R36.1, U2.3 (VI)
unnamed: C17.1, C21.1, R55.1, R56.2, U10.3 (+)
VCC: F1.1, J6.1
VDDA: R55.2; also elsewhere on the board
V_BAT: C20.1, R36.2, R37.1; also elsewhere on the board

Notes on the sheet:
Rozlać miedź na padzie VO do chłodzenia dużym
HY2120-DB - zewnętrzny układ BMS do 2S
Suwak
IP2326 - moduł ładowania zewnętrzny z USB-C
low ESR <500mOhm
+/- z baterii (BMS)

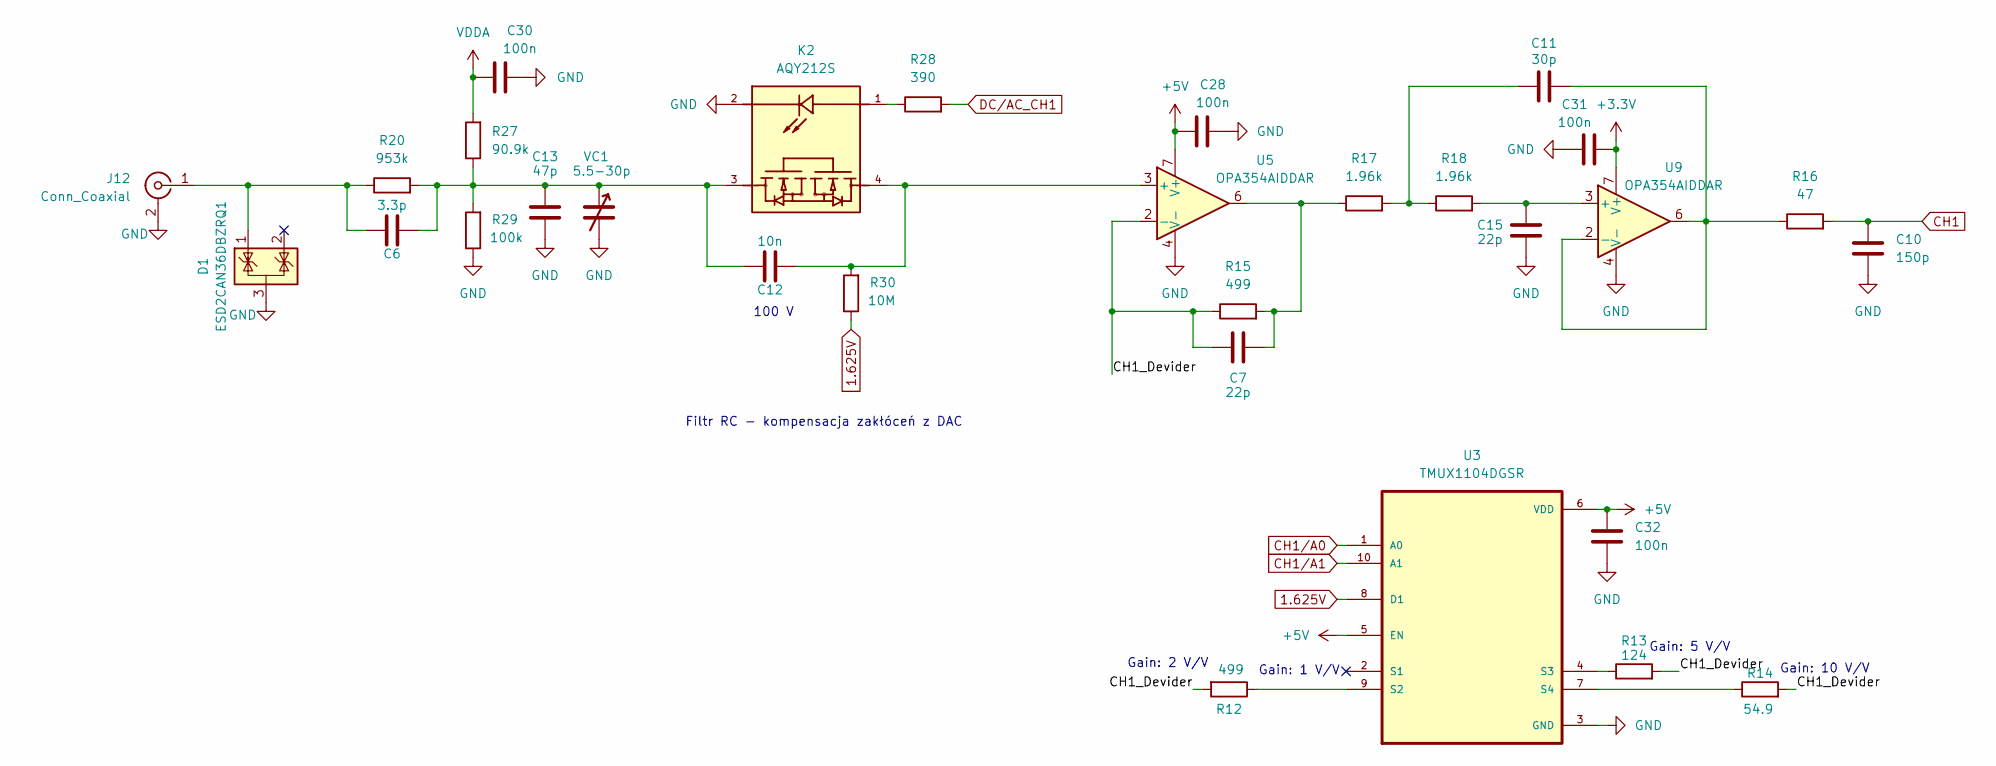
[picture p27: schematic analog_input.kicad_sch]

Parts:
C6: 3.3p; C_0603_1608Metric
C7, C15: 22p; C_0603_1608Metric
C10: 150p; C_0603_1608Metric
C11: 30p; C_0603_1608Metric
C12: 10n; C_0603_1608Metric
C13: 47p; C_0603_1608Metric
C28, C30, C31, C32: 100n; C_0603_1608Metric
D1: ESD2CAN36DBZRQ1; SOT-23
J12: Conn_Coaxial; BNC_Amphenol_B6252HB-NPP3G-50_Horizontal
K2: AQY212S; SOP-4_6.5x2.54; PART_NUMBER_(LCSC) C1525231
R12, R15: 499; R_0603_1608Metric
R13: 124; R_0603_1608Metric
R14: 54.9; R_0603_1608Metric
R16: 47; R_0603_1608Metric
R17, R18: 1.96k; R_0603_1608Metric
R20: 953k; R_0805_2012Metric
R27: 90.9k; R_0805_2012Metric
R28: 390; R_0603_1608Metric
R29: 100k; R_0805_2012Metric
R30: 10M; R_0603_1608Metric
U3: TMUX1104DGSR; SOP50P490X110-10N
U5, U9: OPA354AIDDAR; SOIC-8-1EP_3.9x4.9mm_P1.27mm_EP2.29x3mm
VC1: 5.5-30p; C_Trimmer_Voltronics_JZ

Connections:
1.625V: R30.1, U3.8 (D1); also elsewhere on the board
+3.3V: C31.2, U9.7 (V+); also elsewhere on the board
+5V: C28.1, C32.2, U3.5 (EN), U3.6 (VDD), U5.7 (V+); also elsewhere on the board
/Analog Input CH1/CH1_Devider: C7.2, R12.2, R13.2, R14.2, R15.1, U5.2 (-)
CH1: C10.1, R16.2; also elsewhere on the board
CH1/A0: U3.1 (A0); also elsewhere on the board
CH1/A1: U3.10 (A1); also elsewhere on the board
DC/AC_CH1: R28.2; also elsewhere on the board
GND: C10.2, C13.1, C15.1, C28.2, C30.2, C31.1, C32.1, D1.3 (A), J12.2 (Ext), K2.2, R29.1, U3.3 (GND), U5.4 (V-), U5.9 (V-), U9.4 (V-), U9.9 (V-), VC1.2; also elsewhere on the board
unnamed: C7.1, R15.2, R17.1, U5.6
unnamed: C11.1, R17.2, R18.1
unnamed: C6.2, C12.1, C13.2, K2.3, R20.2, R27.1, R29.2, VC1.1
unnamed: C6.1, D1.1 (K), J12.1 (In), R20.1
unnamed: K2.1, R28.1
unnamed: R12.1, U3.9 (S2)
unnamed: R13.1, U3.4 (S3)
unnamed: R14.1, U3.7 (S4)
unnamed: C12.2, K2.4, R30.2, U5.3 (+)
unnamed: C15.2, R18.2, U9.3 (+)
unnamed: C11.2, R16.1, U9.2 (-), U9.6
VDDA: C30.1, R27.2; also elsewhere on the board

Notes on the sheet:
Filtr RC - kompensacja zakłóceń z DAC
Gain: 10 V/V
Gain: 1 V/V
Gain: 2 V/V
100 V
Gain: 5 V/V

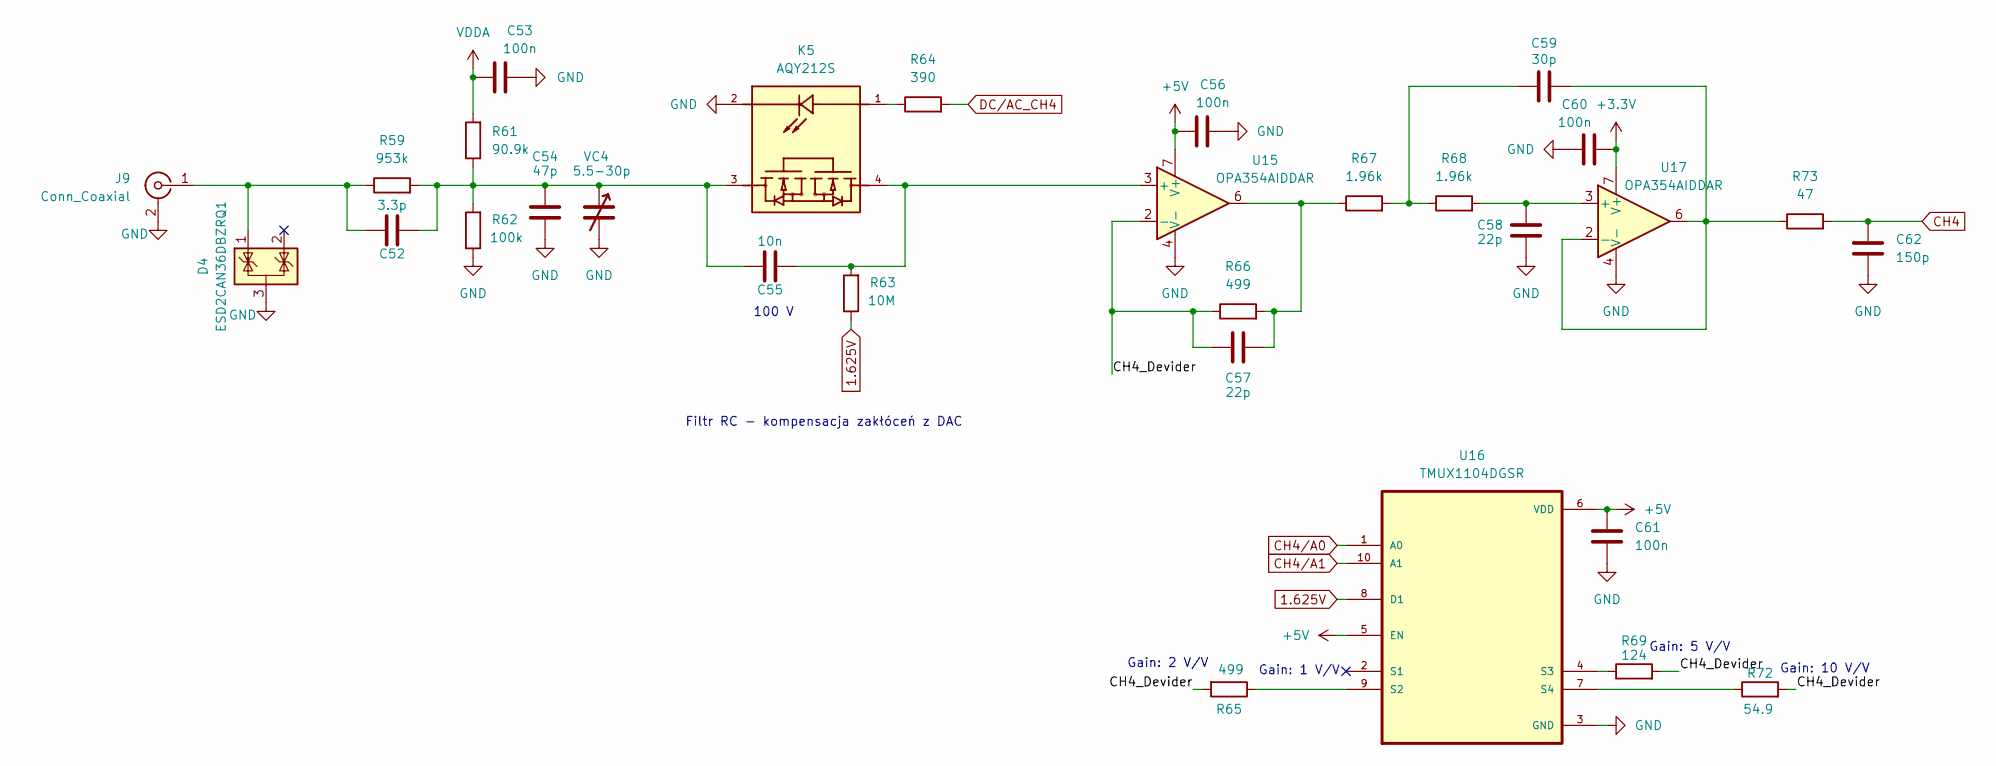
[picture p28: schematic analog_input_ch4.kicad_sch]

Parts:
C52: 3.3p; C_0603_1608Metric
C53, C56, C60, C61: 100n; C_0603_1608Metric
C54: 47p; C_0603_1608Metric
C55: 10n; C_0603_1608Metric
C57, C58: 22p; C_0603_1608Metric
C59: 30p; C_0603_1608Metric
C62: 150p; C_0603_1608Metric
D4: ESD2CAN36DBZRQ1; SOT-23
J9: Conn_Coaxial; BNC_Amphenol_B6252HB-NPP3G-50_Horizontal
K5: AQY212S; SOP-4_6.5x2.54; PART_NUMBER_(LCSC) C1525231
R59: 953k; R_0805_2012Metric
R61: 90.9k; R_0805_2012Metric
R62: 100k; R_0805_2012Metric
R63: 10M; R_0603_1608Metric
R64: 390; R_0603_1608Metric
R65, R66: 499; R_0603_1608Metric
R67, R68: 1.96k; R_0603_1608Metric
R69: 124; R_0603_1608Metric
R72: 54.9; R_0603_1608Metric
R73: 47; R_0603_1608Metric
U15, U17: OPA354AIDDAR; SOIC-8-1EP_3.9x4.9mm_P1.27mm_EP2.29x3mm
U16: TMUX1104DGSR; SOP50P490X110-10N
VC4: 5.5-30p; C_Trimmer_Voltronics_JZ

Connections:
1.625V: R63.1, U16.8 (D1); also elsewhere on the board
+3.3V: C60.2, U17.7 (V+); also elsewhere on the board
+5V: C56.1, C61.2, U15.7 (V+), U16.5 (EN), U16.6 (VDD); also elsewhere on the board
/Analog Input CH4/CH4_Devider: C57.2, R65.2, R66.1, R69.2, R72.2, U15.2 (-)
CH4: C62.1, R73.2; also elsewhere on the board
CH4/A0: U16.1 (A0); also elsewhere on the board
CH4/A1: U16.10 (A1); also elsewhere on the board
DC/AC_CH4: R64.2; also elsewhere on the board
GND: C53.2, C54.1, C56.2, C58.1, C60.1, C61.1, C62.2, D4.3 (A), J9.2 (Ext), K5.2, R62.1, U15.4 (V-), U15.9 (V-), U16.3 (GND), U17.4 (V-), U17.9 (V-), VC4.2; also elsewhere on the board
unnamed: C52.2, C54.2, C55.1, K5.3, R59.2, R61.1, R62.2, VC4.1
unnamed: C57.1, R66.2, R67.1, U15.6
unnamed: C59.1, R67.2, R68.1
unnamed: C52.1, D4.1 (K), J9.1 (In), R59.1
unnamed: K5.1, R64.1
unnamed: C55.2, K5.4, R63.2, U15.3 (+)
unnamed: R65.1, U16.9 (S2)
unnamed: R69.1, U16.4 (S3)
unnamed: R72.1, U16.7 (S4)
unnamed: C58.2, R68.2, U17.3 (+)
unnamed: C59.2, R73.1, U17.2 (-), U17.6
VDDA: C53.1, R61.2; also elsewhere on the board

Notes on the sheet:
Gain: 2 V/V
Filtr RC - kompensacja zakłóceń z DAC
Gain: 5 V/V
Gain: 1 V/V
Gain: 10 V/V
100 V

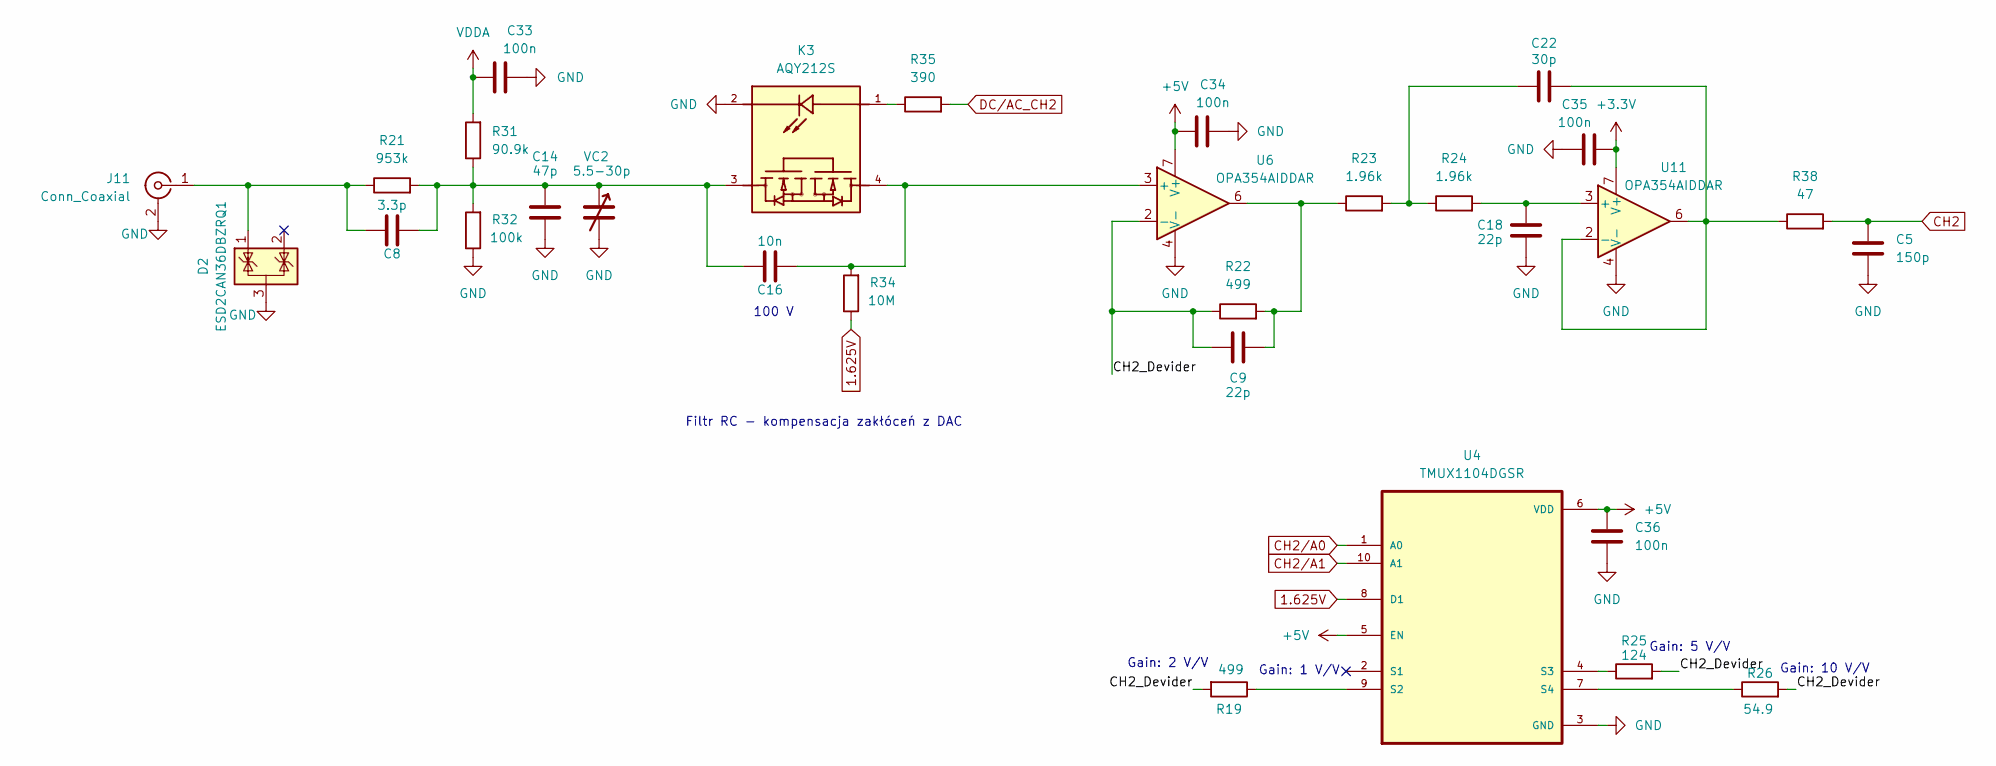
[picture p29: schematic analog_input_ch2.kicad_sch]

Parts:
C5: 150p; C_0603_1608Metric
C8: 3.3p; C_0603_1608Metric
C9, C18: 22p; C_0603_1608Metric
C14: 47p; C_0603_1608Metric
C16: 10n; C_0603_1608Metric
C22: 30p; C_0603_1608Metric
C33, C34, C35, C36: 100n; C_0603_1608Metric
D2: ESD2CAN36DBZRQ1; SOT-23
J11: Conn_Coaxial; BNC_Amphenol_B6252HB-NPP3G-50_Horizontal
K3: AQY212S; SOP-4_6.5x2.54; PART_NUMBER_(LCSC) C1525231
R19, R22: 499; R_0603_1608Metric
R21: 953k; R_0805_2012Metric
R23, R24: 1.96k; R_0603_1608Metric
R25: 124; R_0603_1608Metric
R26: 54.9; R_0603_1608Metric
R31: 90.9k; R_0805_2012Metric
R32: 100k; R_0805_2012Metric
R34: 10M; R_0603_1608Metric
R35: 390; R_0603_1608Metric
R38: 47; R_0603_1608Metric
U4: TMUX1104DGSR; SOP50P490X110-10N
U6, U11: OPA354AIDDAR; SOIC-8-1EP_3.9x4.9mm_P1.27mm_EP2.29x3mm
VC2: 5.5-30p; C_Trimmer_Voltronics_JZ

Connections:
1.625V: R34.1, U4.8 (D1); also elsewhere on the board
+3.3V: C35.2, U11.7 (V+); also elsewhere on the board
+5V: C34.1, C36.2, U4.5 (EN), U4.6 (VDD), U6.7 (V+); also elsewhere on the board
/Analog Input CH2/CH2_Devider: C9.2, R19.2, R22.1, R25.2, R26.2, U6.2 (-)
CH2: C5.1, R38.2; also elsewhere on the board
CH2/A0: U4.1 (A0); also elsewhere on the board
CH2/A1: U4.10 (A1); also elsewhere on the board
DC/AC_CH2: R35.2; also elsewhere on the board
GND: C5.2, C14.1, C18.1, C33.2, C34.2, C35.1, C36.1, D2.3 (A), J11.2 (Ext), K3.2, R32.1, U4.3 (GND), U6.4 (V-), U6.9 (V-), U11.4 (V-), U11.9 (V-), VC2.2; also elsewhere on the board
unnamed: C9.1, R22.2, R23.1, U6.6
unnamed: C8.2, C14.2, C16.1, K3.3, R21.2, R31.1, R32.2, VC2.1
unnamed: C22.1, R23.2, R24.1
unnamed: C8.1, D2.1 (K), J11.1 (In), R21.1
unnamed: K3.1, R35.1
unnamed: R19.1, U4.9 (S2)
unnamed: R25.1, U4.4 (S3)
unnamed: R26.1, U4.7 (S4)
unnamed: C16.2, K3.4, R34.2, U6.3 (+)
unnamed: C18.2, R24.2, U11.3 (+)
unnamed: C22.2, R38.1, U11.2 (-), U11.6
VDDA: C33.1, R31.2; also elsewhere on the board

Notes on the sheet:
Filtr RC - kompensacja zakłóceń z DAC
100 V
Gain: 1 V/V
Gain: 2 V/V
Gain: 5 V/V
Gain: 10 V/V

Board: 2 copper layers, 171 parts (0 on the bottom side), 100 nets, no tracks yet.
