Czolsonn/Oscyloskop/Firmware/Digital Time-Frequency Recorder/Digital Time-Frequency Recorder.ioc

Mcu.UserName=STM32G474RETx
PA0.GPIO_Label=CH3
PA0.Signal=ADC1_IN1
PA1.GPIO_Label=CH4
PA1.Signal=ADC2_IN2
PA10.GPIO_Label=T_PUSH
PA10.Signal=GPIO_Input
PA11.GPIO_Label=T_A
PA11.Signal=S_TIM4_CH1
PA12.GPIO_Label=T_B
PA12.Signal=S_TIM4_CH2
PA13.GPIO_Label=T_SWDIO
PA13.Signal=SYS_JTMS-SWDIO
PA14.GPIO_Label=T_SWCLK
PA14.Signal=SYS_JTCK-SWCLK
PA15.GPIO_Label=Y_PUSH
PA15.Signal=GPIO_Input
PA2.Signal=LPUART1_TX
PA3.Signal=LPUART1_RX
PA4.Signal=COMP_DAC11_group
PA5.Signal=SPI1_SCK
PA6.Signal=SPI1_MISO
PA7.Signal=SPI1_MOSI
PB0.GPIO_Label=CH4_EN
PB0.Signal=GPIO_Input
PB1.GPIO_Label=CH1
PB1.Signal=ADC3_IN1
PB10.GPIO_Label=CH2_EN
PB10.Signal=GPIO_Input
PB11.GPIO_Label=CH3_EN
PB11.Signal=GPIO_Input
PB12.GPIO_Label=DCAC_CH3
PB12.Signal=GPIO_Output
PB13.GPIO_Label=DCAC_CH1
PB13.Signal=GPIO_Output
PB14.GPIO_Label=DCAC_CH2
PB14.Signal=GPIO_Output
PB15.GPIO_Label=CH2
PB15.Signal=ADC4_IN5
PB3.GPIO_Label=T_SWO
PB3.Signal=SYS_JTDO-SWO
PB4.GPIO_Label=X_A
PB4.Signal=S_TIM3_CH1
PB5.GPIO_Label=X_B
PB5.Signal=S_TIM3_CH2
PB6.GPIO_Label=Y_A
PB6.Signal=GPIO_Input
PB7.GPIO_Label=Y_B
PB7.Signal=GPIO_Input
PB9.GPIO_Label=X_PUSH
PB9.Signal=GPIO_Input
PC0.GPIO_Label=V_BAT
PC0.Signal=ADC1_IN6
PC1.GPIO_Label=CH1_EN
PC1.Signal=GPIO_Input
PC10.GPIO_Label=CS_REG
PC10.Signal=GPIO_Output
PC11.GPIO_Label=DC/RS
PC11.Signal=GPIO_Output
PC12.GPIO_Label=CAL_1KHZ
PC12.Signal=S_TIM5_CH2
PC14-OSC32_IN.GPIO_Label=RCC_OSC32_IN
PC14-OSC32_IN.Signal=RCC_OSC32_IN
PC15-OSC32_OUT.GPIO_Label=RCC_OSC32_OUT
PC15-OSC32_OUT.Signal=RCC_OSC32_OUT
PC2.GPIO_Label=RUN_STOP
PC2.Signal=GPIO_Input
PC3.GPIO_Label=AUTO
PC3.Signal=GPIO_Input
PC4.GPIO_Label=CS_DISP
PC4.Signal=GPIO_Output
PC6.GPIO_Label=DCAC_CH4
PC6.Signal=GPIO_Output
PC7.GPIO_Label=LED
PC7.Signal=S_TIM8_CH2
PD2.GPIO_Label=RESET
PD2.Signal=GPIO_Output
PF0-OSC_IN.GPIO_Label=RCC_OSC_IN
PF0-OSC_IN.Signal=RCC_OSC_IN
PF1-OSC_OUT.GPIO_Label=RCC_OSC_OUT
PF1-OSC_OUT.Signal=RCC_OSC_OUT
