Czolsonn/Oscyloskop/(commit log)

2026-03-15 KiCAD - schemat i STM32CubeMX - konfiguracja pinów
    Opis zmian:
    1) KiCAD
    - Podział na Analog Input, STM32 i Power Input
    - Pierwotny schemat z elementami Analog input dla channel 1
    - Dobór STM32G474CET jako mikrokontroler do przetwarzania i wyświetlania sygnałów
    - Wyprowadzenia pinów mikrokontrolera w tym dla programatora ST-LINK3
    - Zasilanie mikrokontrolera
    - Power Input (2 stabilizatory napięcia na 5V i 3.3 V) i zewnętrzne układy do ładowania USB-C i akumulatory Li-ion
    2) STM32CubeMX:
    Konfiguracja pinów od programatora w tym UART
    Piny po dwa na jeden kanał oscyloskopu
    SPI do komunikacji z wyświetlaczem
    ByPASS Oscillator
    [Oscyloskop.kicad_pcb, Oscyloskop.kicad_sch, STM32.kicad_sch, analog_input.kicad_sch, power_input.kicad_sch]
2026-10-03 Add project plan for the December deadline
    Reduced scope (CH1 only, 4 ranges, 4 Msps, 320x240 TFT), measurable
    requirements, a 10-week schedule with the 1 Nov PCB order as the critical
    date, and the simulation / research / validation tasks to start now.
2026-10-04 Simulation: relay model, OPA354 symbol and updated front-end schematic
    - G6K_SPDT: LTspice subcircuit + symbol for one SPDT pole of the Omron G6K-2
    relay (contact resistance 0.1 ohm, 1 pF across open contacts; coil not
    modelled). The .lib is added with -f because *.lib is ignored.
    - OPA354: LTspice symbol for the TI vendor model (the model itself, TI
    package SBOC018C, is not stored in the repository).
    - Analog Front End.asc: final values from the hand calculations (R4 976k,
    R1/R5 57.6k/61.9k, C2 3.3p, C5 27p, Cf 3.7p), component parasitics,
    gain stage with Rg to Vref, real OPA354 buffers on the 5 V rail,
    decoupling of the 1.65 V reference, single 3.3 V rail, solver options and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
2026-10-04 Simulation results: bandwidth, AC mode, C trim and zero-input operating point
    Schematic copies, plots (PNG), exported data (TXT) and plot settings (PLT)
    for the first simulation runs of the CH1 front end:
    - AC bandwidth for G = 1, 3, 10, 20 (DC-coupled)
    - AC-coupled mode (relay energized) down to 0.1 Hz
    - compensation of the input divider by sweeping the C5 trimmer
    - DC operating point at zero input for each gain
2026-10-04 Simulation: Monte Carlo tolerance analysis of the CH1 front end
    30 random runs per case (mc() tolerances on the passives) for three
    tolerance sets (resistors 0.1 %/1 %, capacitors 5 %/1 %), G = 1 and G = 20,
    in DC and AC coupling:
    - gain accuracy follows the resistor grade (0.1 % -> +-0.2 %, 1 % -> +-1.5 %)
    - flatness up to 1 MHz follows the capacitor tolerance and strays
    (5 % -> -8..+4 % at 1 MHz, 1 % -> -2..+1 %), so the C5 trimmer is needed
    - DC offsets are repeatable (spread ~1 mV at G = 1, ~20 mV at G = 20); the
    AC-mode offset at G = 20 is +1.25 V and needs the DAC trim
    - a 158 kHz dip at G = 20 comes from the 10 uF capacitor on Vref
    Includes the schematics, figures, per-run CSV da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
2026-10-21 Simulation: 4-channel front end, thesis figures and folder cleanup
    - Master schematic updated to the 4-channel design: VREF+ 3.25 V, divider
    90.9k/100k/953k, trimmer 15.6 pF, 10M AC bias, TMUX1104 gain control
    (.param gsel 0..3 = G1/2/5/10), PhotoMOS AC/DC (.param kAC), Gear integration.
    - Fig01-Fig09: one LTspice file per thesis figure (.plt sets the axes);
    LTspice screenshots in plot's/AFE_v2/LTspice_figures (runs/afe_figs.py,
    runs/ltshot.ps1). Analog Front End_v2_1_AC.asc has the .meas results.
    - Everything of the old 1-channel relay design moved to _archiwum_stary_uklad/.
    - README.md describes the folder.
2026-10-21 Docs: final values and calculations of the 4-channel analog front end
    Component table (KiCad and LTspice designators), hand calculations of the
    divider, compensation, AC coupling, PGA gains and anti-aliasing filter,
    measurement ranges, simulation results and figure captions for the thesis.
2026-10-21 KiCad: 4-channel schematic finished, footprints, net classes, PCB started
    - Supervisor redesign: NUCLEO-G474RE, 4 analog input sheets (TVS, compensated
    divider, PhotoMOS AC/DC, OPA354 + TMUX1104 PGA, Bessel AA filter), 74HC595
    gain control, power input with VMID buffer. ERC: 0 errors.
    - Parts chosen with LCSC numbers (C0G for all signal capacitors, 0.1 % thin
    film for the divider and VMID resistors, Knowles JZ300 trimmer,
    Kinghelm KH-BNC50-3511 BNC); footprints assigned to every part.
    - Project footprint library Oscyloskop.pretty: generic EC11 encoder with
    switch, cntitle BNC-KWE-18 (spare).
    - Net classes Power_In / Power / Input / Analog / Default and track and via
    presets, set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
2026-11-07 Firmware: CubeIDE project, ILI9341 driver and DMA strip renderer
    - New NUCLEO-G474RE project (156 MHz, ADC clock 52 MHz) with the pinout of the PCB.
    - lcd.c: blocking ILI9341 driver (init, rectangles, 5x7 text).
    - gfx.c: 300x200 waveform area drawn in 300x10 strips, SPI1 DMA ping-pong.
    - app.c: screen layout demo with four synthetic traces; 37 fps at SPI 39 MHz, -O2.
    - Docs: firmware architecture (superloop, data flow, memory, timebase table), updated plan.
    - .gitignore: CubeIDE workspace and build output.
2026-11-07 Firmware: 4-channel simultaneous acquisition (steps A4, A5)
    - acq.c: block acquisition, ADC3+ADC4 (CH1 PB1, CH2 PB15) and ADC1+ADC2 (CH3, CH4) in dual
    regular simultaneous mode, one TIM6 trigger, two 32-bit DMA streams.
    - Slave ADCs need overrun = data overwritten, otherwise their channel freezes (set in acq_init).
    - Sampling rate 3.467 MSa/s verified: 2048 samples take ideal + ~50 cycles at both 45 and 48 ticks.
    - app.c: DAC1 test sine on PA4, auto trigger with fractional-sample position, one band per channel.
    - Plan: A2-A5 marked done with measured results.
2026-11-07 Firmware: trigger modes and timebase (steps A6, A7) + PC remote
    - app.c: settings, RUN/STOP, AUTO/NORM/SINGLE, trigger channel/edge/level (manual or auto 50 %),
    text commands over the ST-LINK VCP and a #S status line every second.
    - acq.c: 15 timebases 1 us ... 50 ms/div (30 px/div), TIM6 prescaler/period and ADC hardware
    oversampling for slow timebases, block length per timebase, falling-edge trigger.
    - link.c: LPUART1 RX interrupt + line buffer; ui.c: Nucleo B1 = RUN/STOP; gen.c: DAC test
    generator on PA4 (sine/square/triangle, 1 Hz - 100 kHz).
    - tools/remote.py: Tkinter remote control replacing the board buttons while testing on the bare Nucleo.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
2026-11-07 Firmware: board controls, gain/AC-DC and input-volt scaling (C1, C2)
    - afe.c: 74HC595 gain (G1 sent at start-up, SPI slowed to 9.75 MHz for the register) and
    PhotoMOS AC/DC per channel; acquisition block discarded after a change.
    - ui.c: board buttons and encoders (T: timebase/edge, X: trigger level/auto, Y: gain/AC-DC of the
    active channel, CH1-4, RUN/STOP with long press = SINGLE, AUTO) issue the same text commands as
    the PC remote; internal pull-ups so pins can be tested on the bare Nucleo.
    - app.c: trigger edge/level remembered per channel, enabled channels share the screen height,
    readings in volts at the BNC input (or at the ADC pin for bare-Nucleo tests).
    - tools/remote.py: pe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
2026-11-14 Firmware: PCB bring-up - continuous axes, menu, zero calibration, battery
    - Encoders by board labels: T = trigger level (push = menu), X = time axis, Y = volt axis;
    push on X/Y toggles scale / position (horizontal position, vertical offset).
    - Continuous V/div (50 mV ... 50 V, 1-1.2-1.5-2-2.5-3-4-5-6-8) with automatic gain G1..G10:
    the largest gain whose linear range covers the visible window.
    - Continuous T/div (1 us ... 50 ms) on 13 sample-rate configurations, fractional samples per pixel.
    - Menu (top right): probe x1/x10, AC/DC, measurements (Vpp, Vmax, Vmin, Vavg, Vrms, f),
    trigger source/edge, oversampling, 1 kHz on J13, scale, zero calibration. Text overlays rendered
    in the str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
