Czolsonn/Oscyloskop/(notices)

Notices in the files:
Firmware/Digital Time-Frequency Recorder/Core/Src/gpio.c:
Copyright (c) 2026 STMicroelectronics.
All rights reserved.
This software is licensed under terms that can be found in the LICENSE file
